Lu-Chengyu/TR19/TR19_DR/TR19_DR.pdf

共 39 页 第 1 页

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
# 传动系统设计报告

## 编著：陆成禹 胡啸 梁家豪

共 39 页 第 2 页

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
共 39 页 | 第 3 页 ┊┊┊┊┊┊┊┊┊┊┊┊┊装┊┊┊┊┊订┊┊┊┊┊线┊┊┊┊┊┊┊┊┊┊┊┊┊ | 1 设计目标 加速性能，传递效率，可靠性，轻量化。

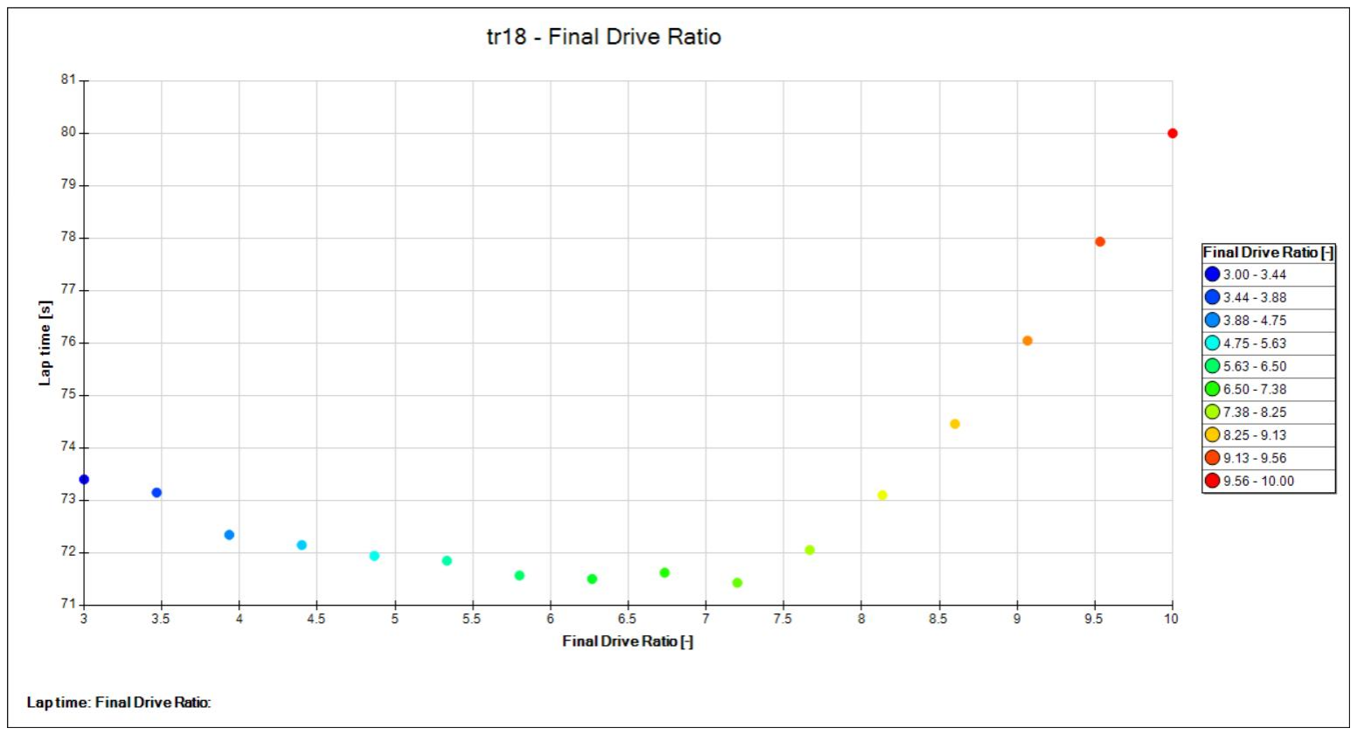
[picture p1: figure]
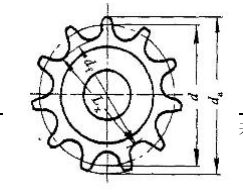
[picture p2: figure]

共 39 页 第 4 页

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
## 2 设计步骤

主减速比的选择
各部件的受力计算
借助 CAE 分析优化结构

2.1.主减速比的选择

我们用 Optimum lap 对中国赛赛道进行了仿真。图表中 X 轴是减速比，Y 轴是最快圈速。根 据仿真结果，我们可以看出减速比在 6~8 之间，减速比对最快圈速的影响最小。次减速比为 1.974， 所以主减速比的范围为 3~4。
根据以往赛季的数据，赛车直线加速的最终速度为 v = 109km / h = 30.28m / s。 当轮胎压力

## 为 0.8bar 时，车轮的滚动半径为 235.1mm。 根据 v =2πnr（n ----加速时的最终车轮转速），有 n= v /2πr=21.81r/ S =1308.4r/min。

为了节省换档时间，我们的换档策略是在加速完成时达到换档点。 因此，我们使发动机的 速度达到 12810r / min，达到齿轮 3 到齿轮 4 的换档点。

小链轮的齿不应太小，因为这会导致小的交叉角，每个齿承受太大的负荷。 但是，由于空 间的限制，轮齿也不能太大。 所以我们选择链轮的齿数为素数 11。

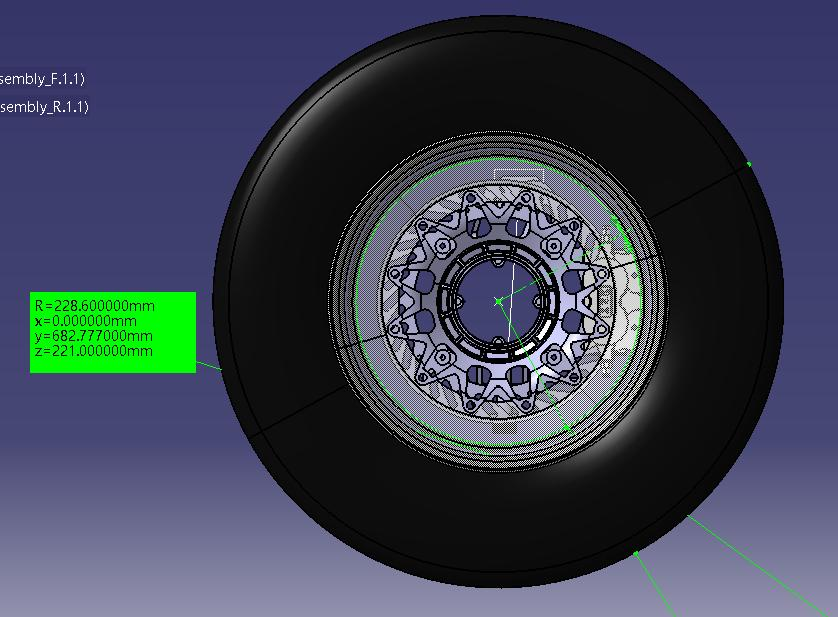
[picture p3: figure]

共 39 页 第 5 页

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
图 2.4 小链轮

另外，TR-19 轮胎重 6.7 千克，具有一定的转动惯量。

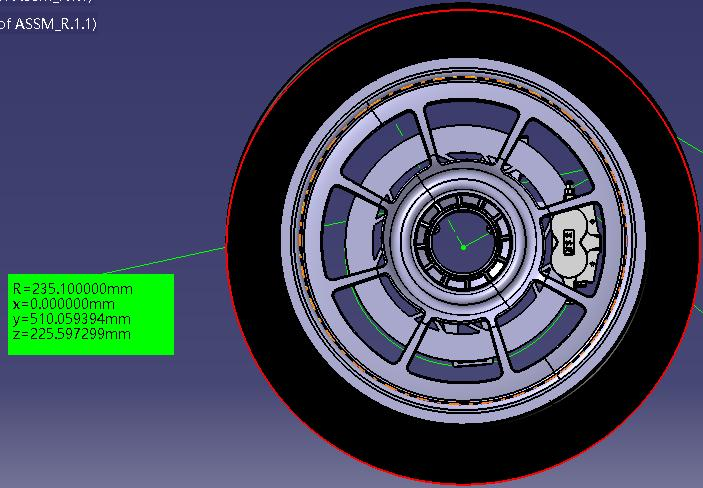
[picture p4: figure]

图 2.5 TR-18 | 图 2.6 TR-17

结合上一辆车 TR18 的主减速比 38：11，最终我们选择保持传动比不变，将 TR19 的主减速

## 比定为 38:11。

2.2.各部件的受力计算

发动机最大输出扭矩 M：54N.m

小链轮上的扭矩 M1

大连轮上的扭矩 M2

发动机提供给半轴的扭矩 M3

赛车加车手总重 M4：270kg

赛车重心高度 h：321mm

共 39 页 第 6 页

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
## 赛车前后轴距 L：1578.5mm

静载荷前后分配：45：55

## 车轮滚动半径 r0：235.1mm

2.2.1 支撑受力

支撑受力分析

= + + + ∆1 + ∆2 (2.1)

其中：
：紧边拉力

：有效圆周力

：离心力引起的拉力

：悬垂拉力
= + (2.2)

其中：
：松边拉力
v =
1p

60×1000 =
11×15.875×2182.77

60×1000 = 6.35 (2.3)

其中：
1:小链轮齿数

：链条节距

：小链轮转速

大、小链轮分度圆半径
1 = 28.2
2 = 28.2 ×

38
11 = 97.4

链条变速运动最大加速度
=

# 21 sin

180° 1 =
6.35

# 2 28.2×10−3 sin

180° 11 = 402.84/
2 | (2.4)

共 39 页 第 7 页

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
从动链轮角加速度
2 d =

# 2cos (180° 2) =

402.84

# 97.4×10−3×cos (180° 38) = 4150.11rad/

2
(2.5)

其中：
2：大链轮转速

2：大链轮齿数

发动机输出有效圆周力
= 1000

= 1000 ×
55

6.35 = 8661.42 （2.6）

其中：
:发动机输出功率

链条离心力引起拉力
=

2 = 1.02 × 6.35

2 = 41.13 (2.7)

其中：
：链条单位长度质量

链条垂悬拉力
= + s = 25 + s0° × 1.02 × 0.1902 × 100 = 486.44 (2.8)

其中：
：大小链轮中心线与水平面夹角

：链传动中心距

：重力加速度

：垂度系数

的值参考下图选取

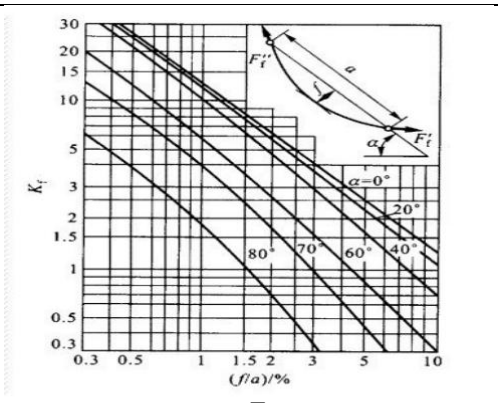
[picture p5: figure]

共 39 页 第 8 页

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
图 2.7

链速变化引起惯性力
∆1 = = 1.02 × 0.82 × 402.84 = 328.72 (2.9)

其中：
：紧边链条的长度

角加速度引起的惯性力

∆2 =

2 ×

2 d =
0.002×4150.11

97.4×10−3 = 85.22 (2.10)

其中：
：从动系统转化到从动链轮轴上的转动惯量

所以
= + + + ∆1 + ∆2 = 9602.93 | (2.1)
= + =527.57N | (2.2)

共 39 页 | 第 9 页 ┊┊┊┊┊┊┊┊┊┊┊┊┊装┊┊┊┊┊订┊┊┊┊┊线┊┊┊┊┊┊┊┊┊┊┊┊┊ | 图 2.8 链传动布置简图 = cos 20.934° + cos 20.934° = 9461.82 | (2.12) = sin 20.934° − sin 20.934° = 3240.88 | (2.13) X 方向 | 图 2.9 Y 方向

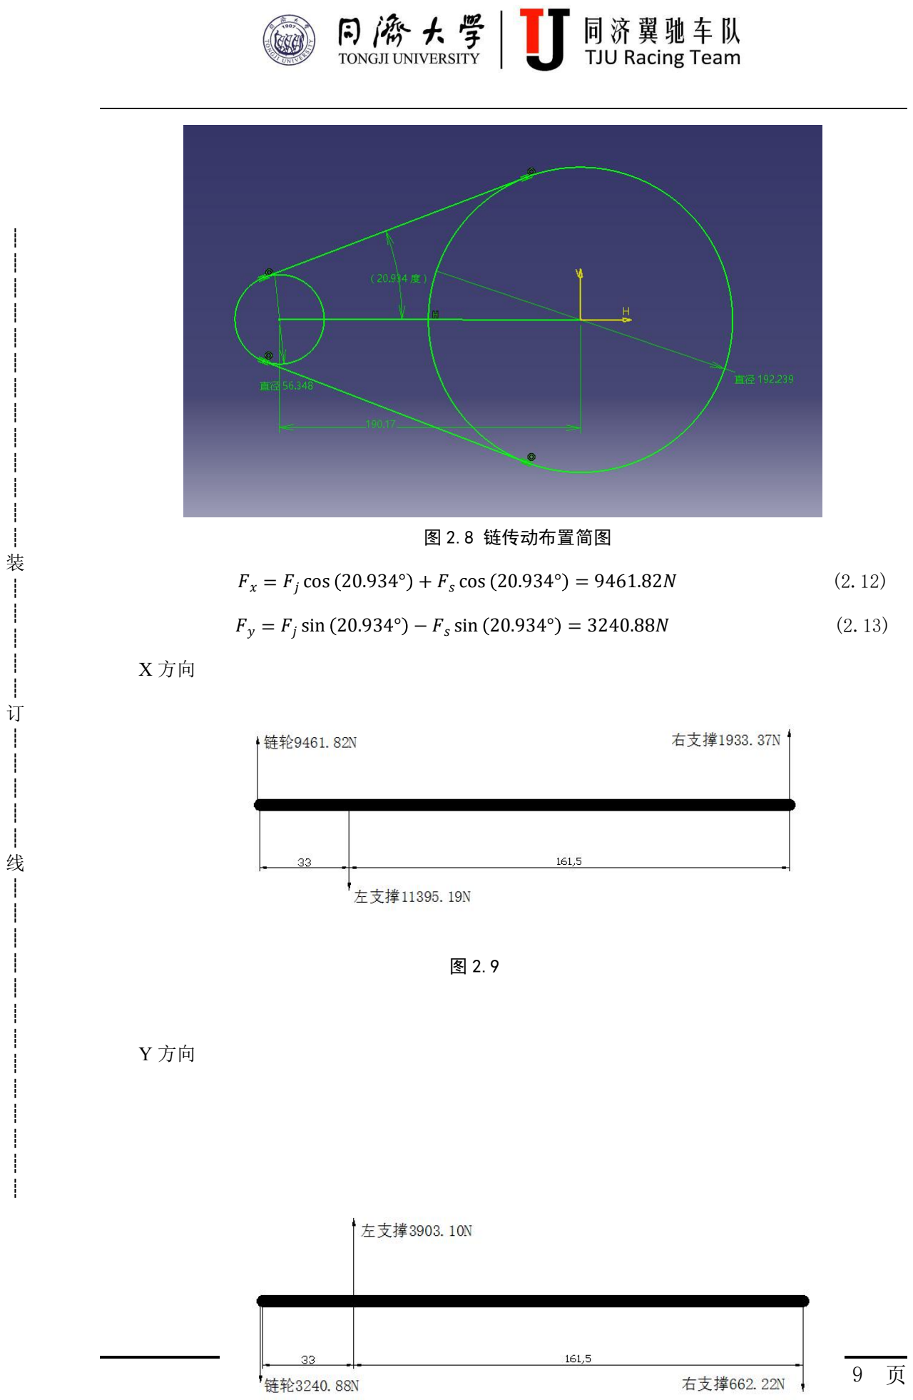
[picture p6: page 9]

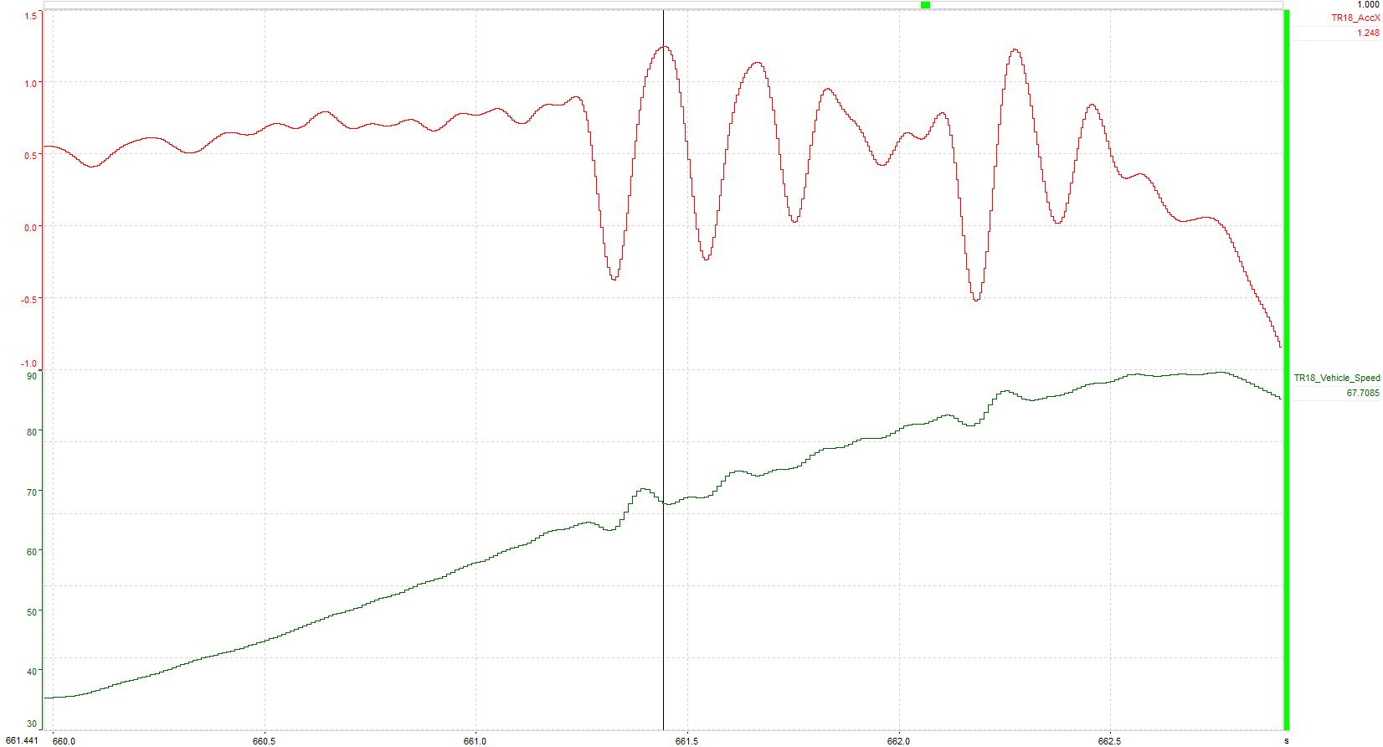
[picture p7: figure]

共 39 页 第 10 页

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
图 2.10

2.2.2 扭矩计算

发动机提供的扭矩：
1 = × 0 × 2.785 = 269.38 ∙ (2.14) 2 = 1 × = 269.38 ×
38
11 = 930.59 ∙ | (2.15)
3 = 2 ÷ 2 = 930.59 ÷ 2 = 465.29 ∙ | (2.16)

根据测试的数据收集计算轮胎提供的扭矩。 （详细数据见附件）

图 2.11 后轮最大垂直力下的速度和加速度

根据图 2.8，最大加速度 a = 1.248g，v = 67.7km / h。

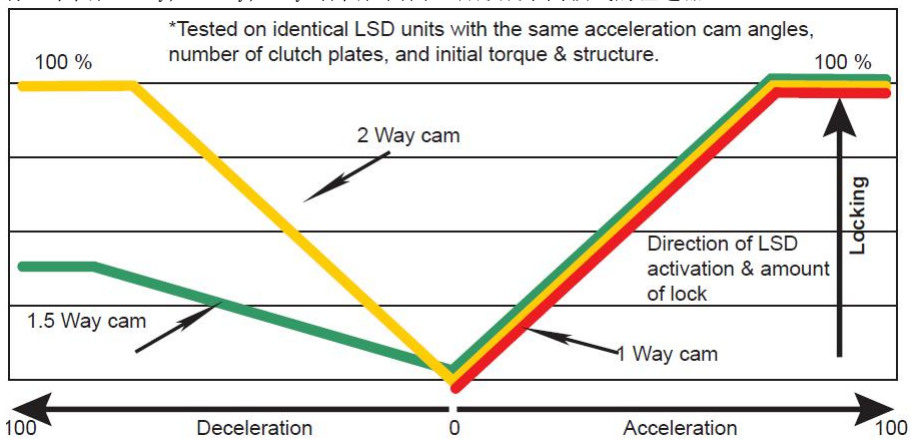
[picture p8: figure]

共 39 页 第 11 页

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
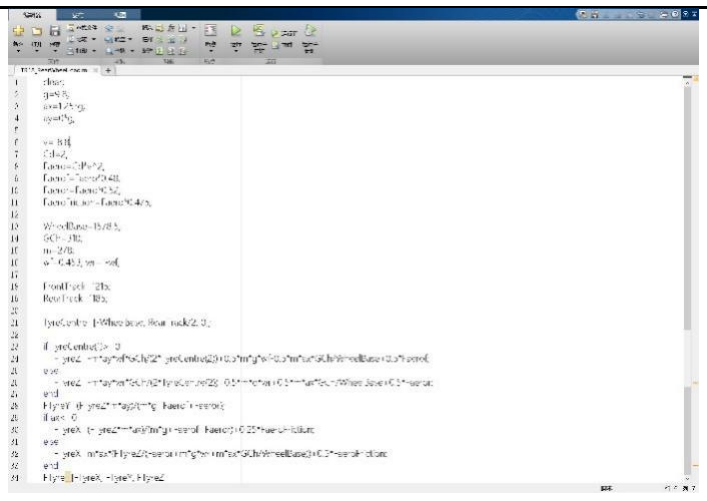
[picture p9: figure]

图 2.12 Matlab 计算

从 MATLAB 我们可以看出 y 轴上的最大应力是 1870.6N。 轮胎半径为 235mm。 我们可以得到 最大扭矩为 439.6Nm。 又 439.6Nm <465.29Nm，我们选择 465.29Nm 作为模拟时的最大扭矩。

2.3 结构设计及其仿真优化

2.3.1CUSCO 差速器与差速器壳分析

Cusco 最大的优势是锁紧系数和限滑系数可调，同时 cusco 每款差速器具有两档可调（一共 有三个档位 1way,1.5way,2way.各档位两两组合形成不同款式的差速器）。

图 2.13 Cusco 差速器各档位与锁紧系数关系[3]

图 2.13 是 Cusco 不同档位的特性图。各档位加速时性能都一样。在减速时：1way 没有摩擦 扭矩，锁紧系数始终为 0；1.5way 锁紧系数逐渐上升到 0.375 左右；2.0way 锁紧系数能达到 1。

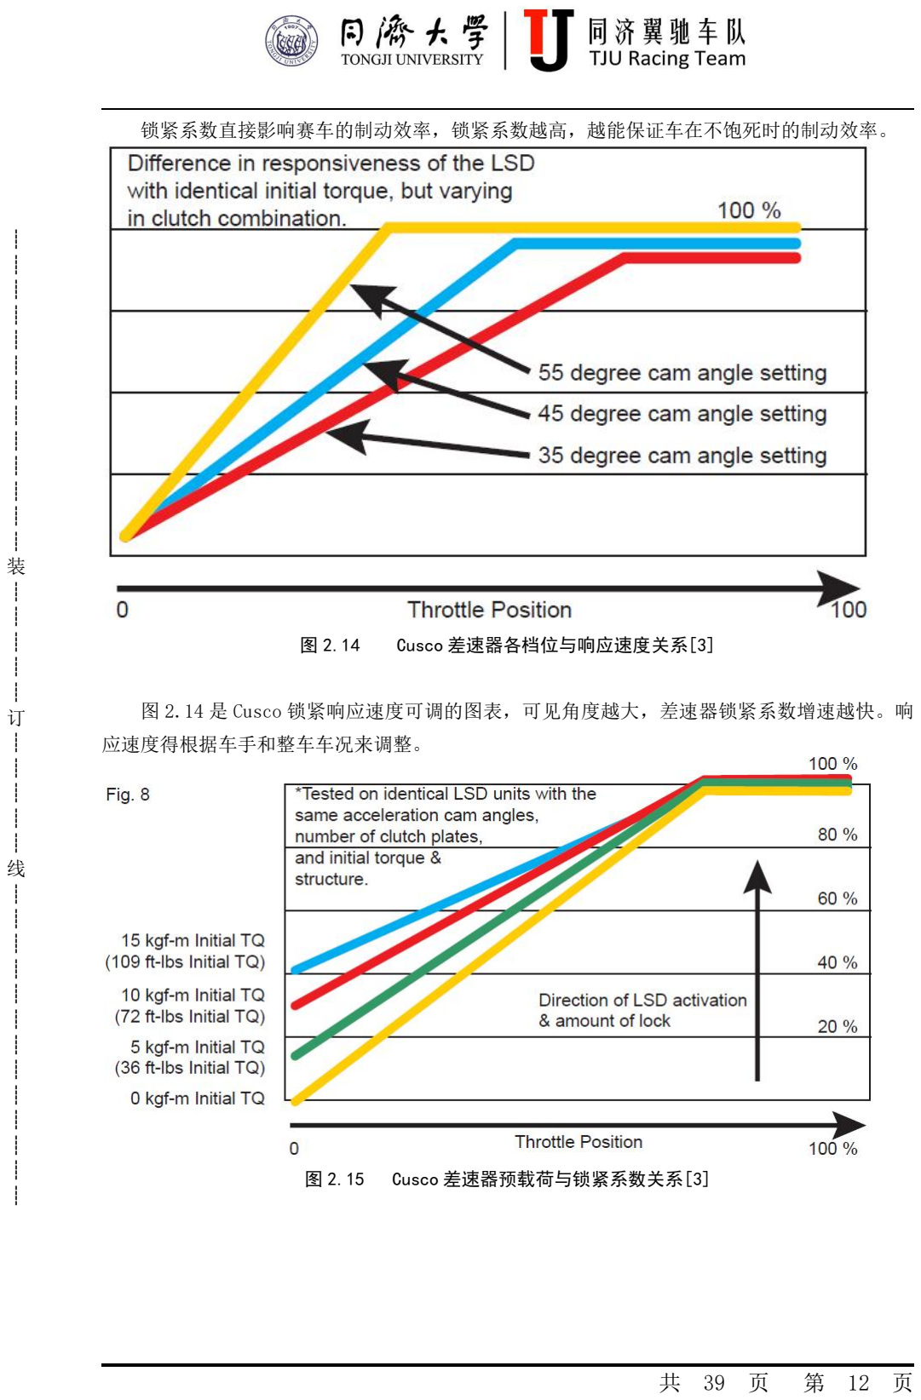
[picture p10: page 12]

共 39 页 第 12 页

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
锁紧系数直接影响赛车的制动效率，锁紧系数越高，越能保证车在不饱死时的制动效率。

图 2.14 Cusco 差速器各档位与响应速度关系[3]

图 2.14 是 Cusco 锁紧响应速度可调的图表，可见角度越大，差速器锁紧系数增速越快。响 应速度得根据车手和整车车况来调整。

图 2.15 Cusco 差速器预载荷与锁紧系数关系[3]

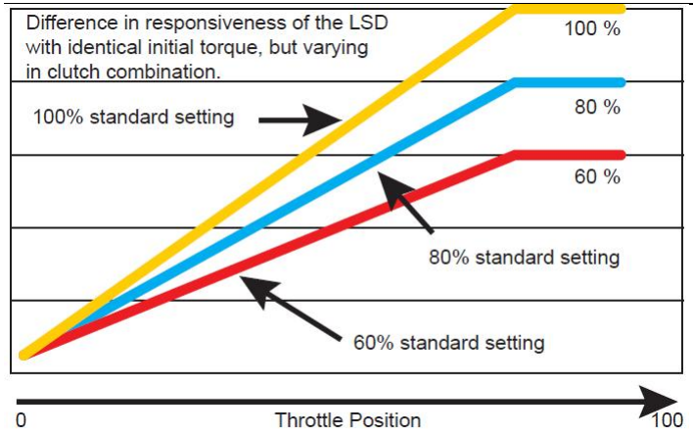
[picture p11: figure]

共 39 页 第 13 页

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
图 2.16 Cusco 差速器摩擦片排序与锁紧系数关系[3]

图 2.15 与图 2.16 是 Cusco 锁紧系数可调的图表，图 2.15 是通过调整预紧力来调整起始锁 紧系数，图 2.16 是通过调整摩擦片顺序来调整最大锁紧系数。这些得通过赛道和车况以及车手 感受来调整。下面是一个实车调整的情况。

由于以上特性，所以我们选择了 CUSCO 差速器。

原装的 cusco 差速器壳的材料是钢，重量比较大，为了满足轻量化的要求，我们决定自制差 速器壳。材料方面我们选用 7075 铝，这样能够保证了外壳的强度。并且在表面进行了阳极氧化

处理，增加了表面的硬度。在保证了可靠性的同时确保其密封性，在左右外壳的端口都采用双油 封密封，左右外壳连接处采用 O 型圈密封。

鉴于链轮以及差速器壳将承受 930.6N.m 的扭矩，考虑见小链轮的实际冲击载荷以及链轮的

轻量化，将采用渐开线花键形式连接链轮和差速器壳。

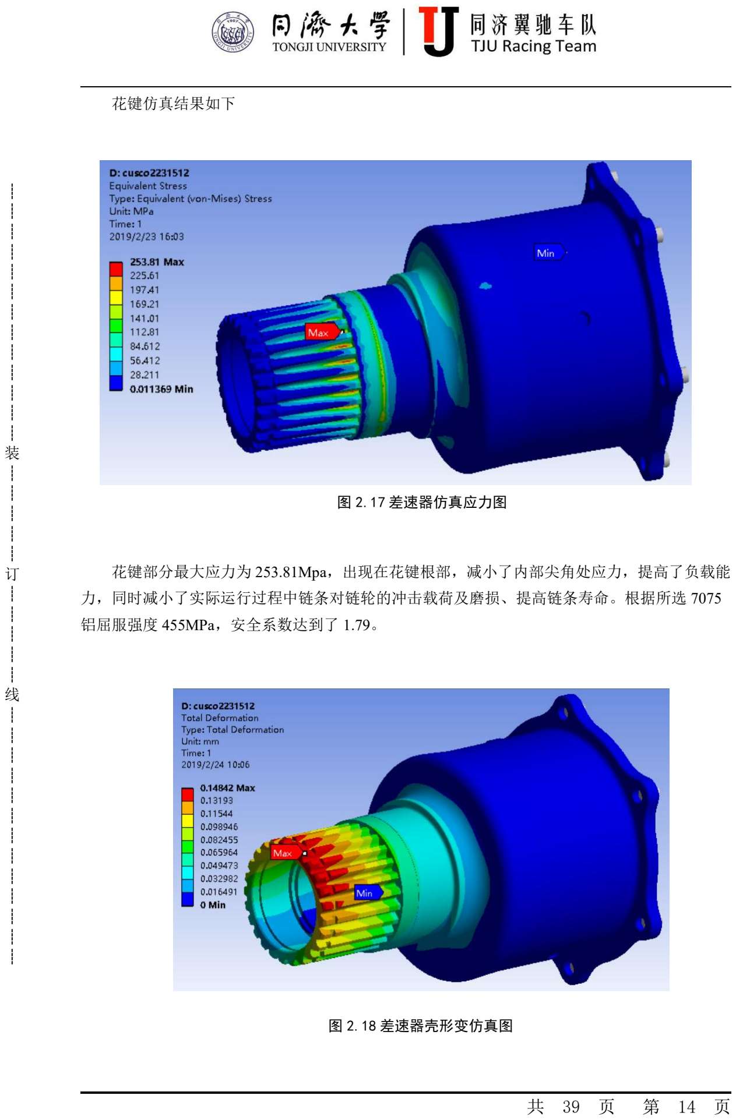
[picture p12: page 14]

共 39 页 第 14 页

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
花键仿真结果如下

图 2.17 差速器仿真应力图

花键部分最大应力为 253.81Mpa，出现在花键根部，减小了内部尖角处应力，提高了负载能 力，同时减小了实际运行过程中链条对链轮的冲击载荷及磨损、提高链条寿命。根据所选 7075 铝屈服强度 455MPa，安全系数达到了 1.79。

图 2.18 差速器壳形变仿真图

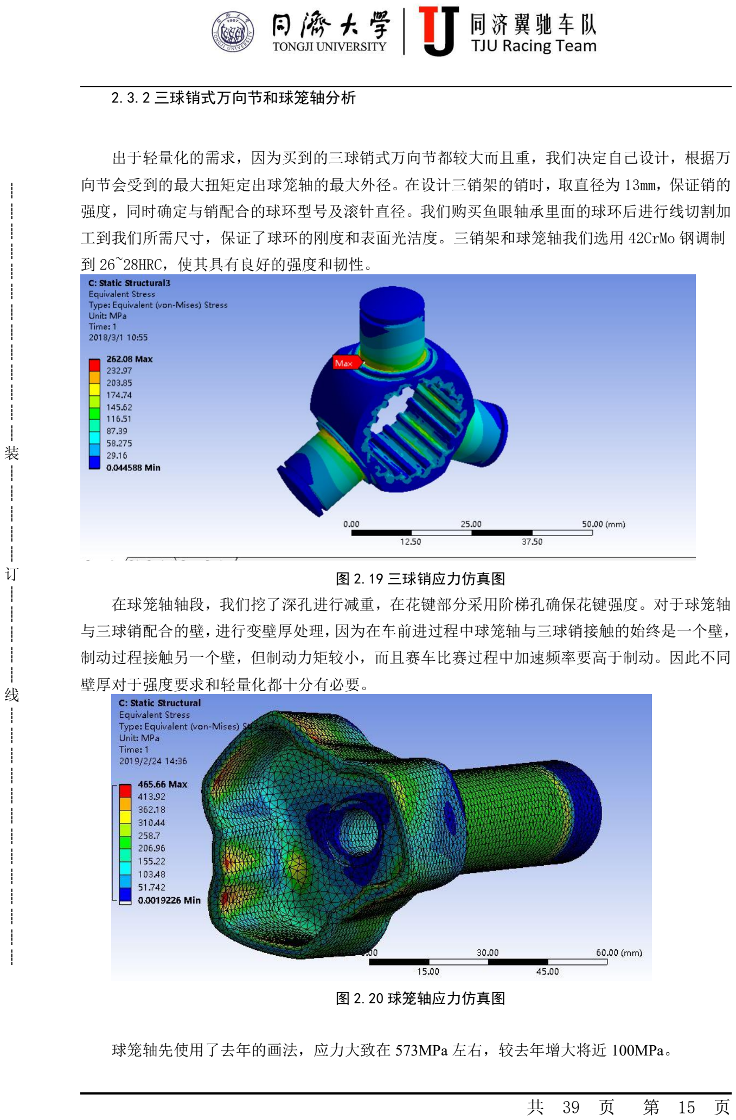
[picture p13: page 15]

共 39 页 第 15 页

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
2.3.2 三球销式万向节和球笼轴分析

出于轻量化的需求，因为买到的三球销式万向节都较大而且重，我们决定自己设计，根据万 向节会受到的最大扭矩定出球笼轴的最大外径。在设计三销架的销时，取直径为 13mm，保证销的 强度，同时确定与销配合的球环型号及滚针直径。我们购买鱼眼轴承里面的球环后进行线切割加 工到我们所需尺寸，保证了球环的刚度和表面光洁度。三销架和球笼轴我们选用 42CrMo 钢调制 到 26~28HRC，使其具有良好的强度和韧性。

图 2.19 三球销应力仿真图
在球笼轴轴段，我们挖了深孔进行减重，在花键部分采用阶梯孔确保花键强度。对于球笼轴 与三球销配合的壁，进行变壁厚处理，因为在车前进过程中球笼轴与三球销接触的始终是一个壁， 制动过程接触另一个壁，但制动力矩较小，而且赛车比赛过程中加速频率要高于制动。因此不同 壁厚对于强度要求和轻量化都十分有必要。

图 2.20 球笼轴应力仿真图

球笼轴先使用了去年的画法，应力大致在 573MPa 左右，较去年增大将近 100MPa。

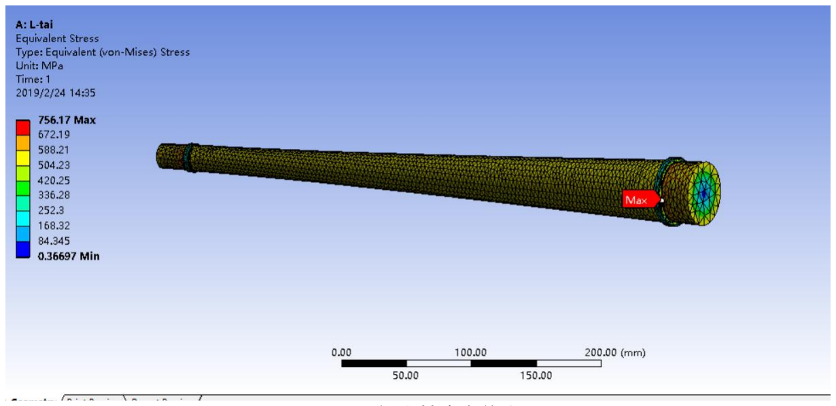
[picture p14: figure]

共 39 页 第 16 页

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
于是今年的球笼轴在厚壁的画法上做了一些改动，从仿真结果可以看出，最大应力集中在囚

笼位置为 465MPa 左右，较去年减少 26MPa。质量较去年减少 20g。

2.3.3 半轴分析

处于轻量化考虑，我们在 TR17 上装备了钛半轴，效果较好，今年我们决定在 TR18 上继续使 用钛半轴。半轴是传动系统的重要受力部件之一，为了确保钛半轴的可靠性，我们在学院实验室 做了钛半轴和钢半轴的扭转试验对比。（详见附录）
由于钛合金材料的加工特性，我们设计了不同于钢半轴的花键。将加工工艺由原来的电火花 成型改为了滚齿成型。同时也体现出了自制三销轴万向节的便利性，可以根据半轴想要的花键而 变更设计。
从仿真结果来看，最大应力点在轴肩底部，大小为 756.17MPa，符合我们的设计需求。 同时考虑成本，对空心钢半轴也进行了仿真，对比钛半轴空心钢增重 220 克左右，但受力情 况较好。

图 2.2.1 钛半轴应力仿真图

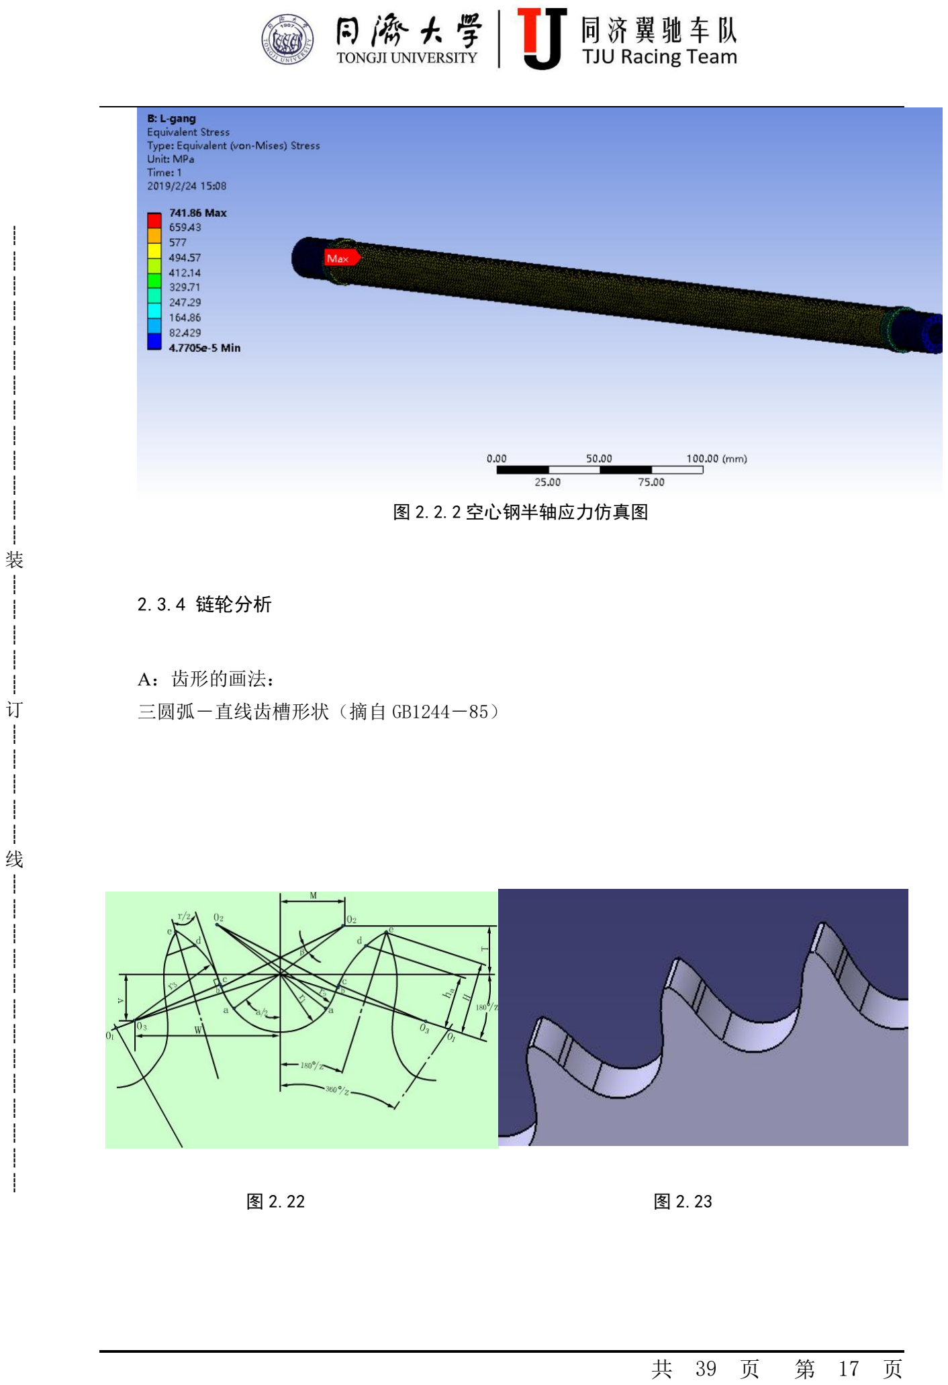
[picture p15: page 17]

共 39 页 | 第 17 页 ┊┊┊┊┊┊┊┊┊┊┊┊┊装┊┊┊┊┊订┊┊┊┊┊线┊┊┊┊┊┊┊┊┊┊┊┊┊ | 图 2.2.2 空心钢半轴应力仿真图 2.3.4 链轮分析 A：齿形的画法： 三圆弧－直线齿槽形状（摘自 GB1244－85） 图 2.22 | 图 2.23

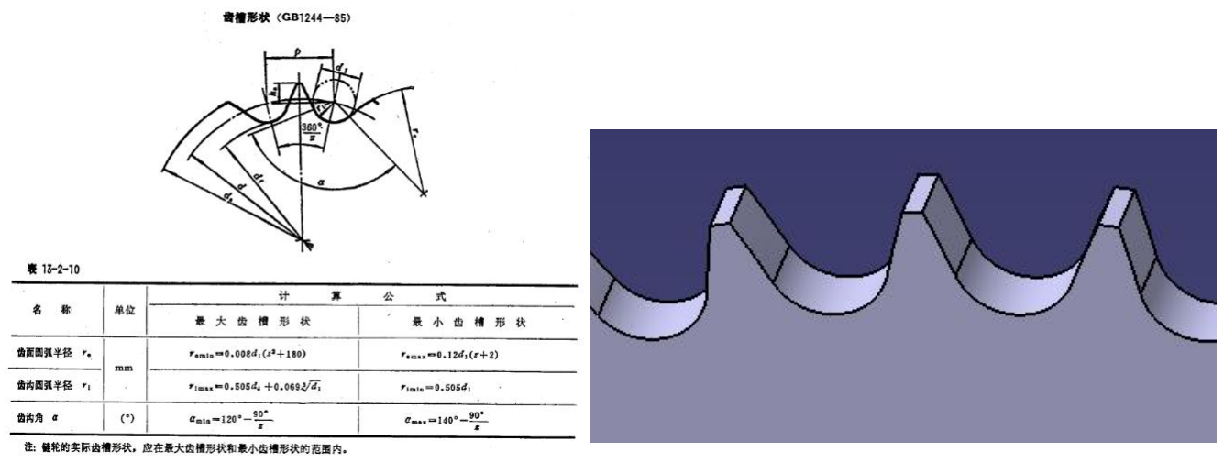
[picture p16: figure]

共 39 页 第 18 页

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
二圆弧法

图 2.24 | 图 2.25
比较以上两种画法发现，三圆弧法优势有：目前比较标准的画法，用标准刀具加工，取值比 较确定；不容易跳齿；磨损较小。且镂空结构相同时，三圆弧法得到的链轮强度更好，最终选取 三圆弧法确定齿形。

B 镂空部分的设计

设计几种不同的镂空部分形状，结合 Ansys 仿真分析后，发现几种设计中，去年的设计受力 更为合理。
由于采用全新的镂空方式，最大应力达到 283Mpa。

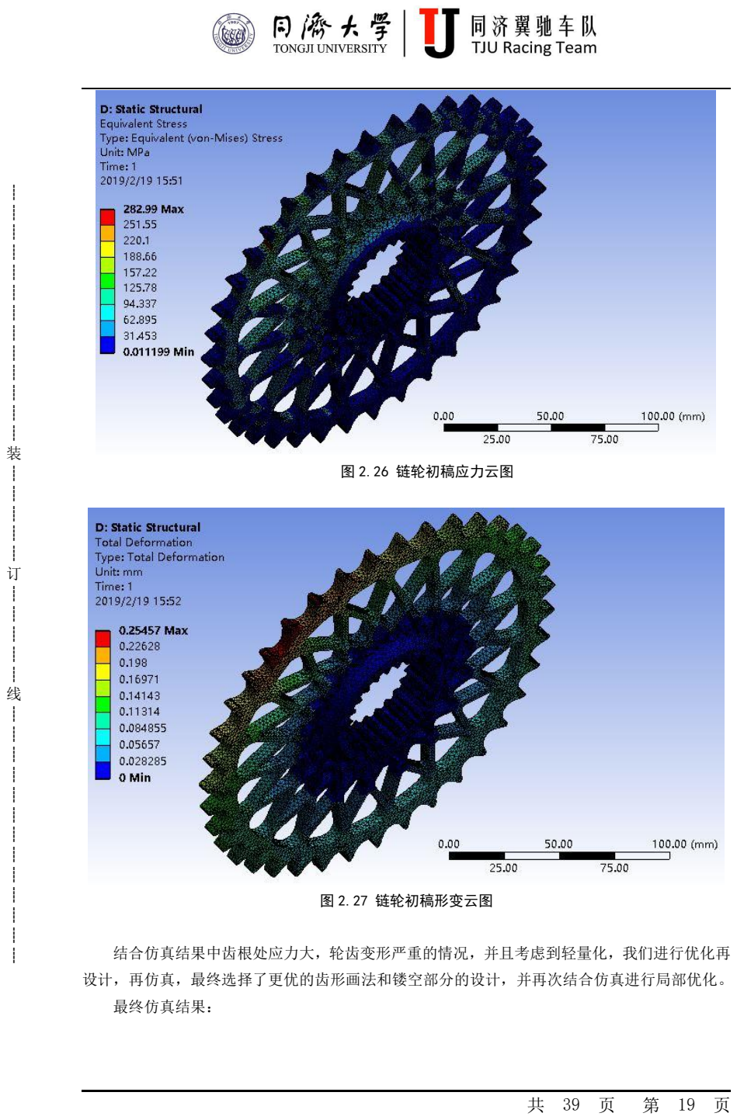
[picture p17: page 19]

共 39 页 第 19 页

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
图 2.26 链轮初稿应力云图

图 2.27 链轮初稿形变云图

结合仿真结果中齿根处应力大，轮齿变形严重的情况，并且考虑到轻量化，我们进行优化再 设计，再仿真，最终选择了更优的齿形画法和镂空部分的设计，并再次结合仿真进行局部优化。 最终仿真结果：

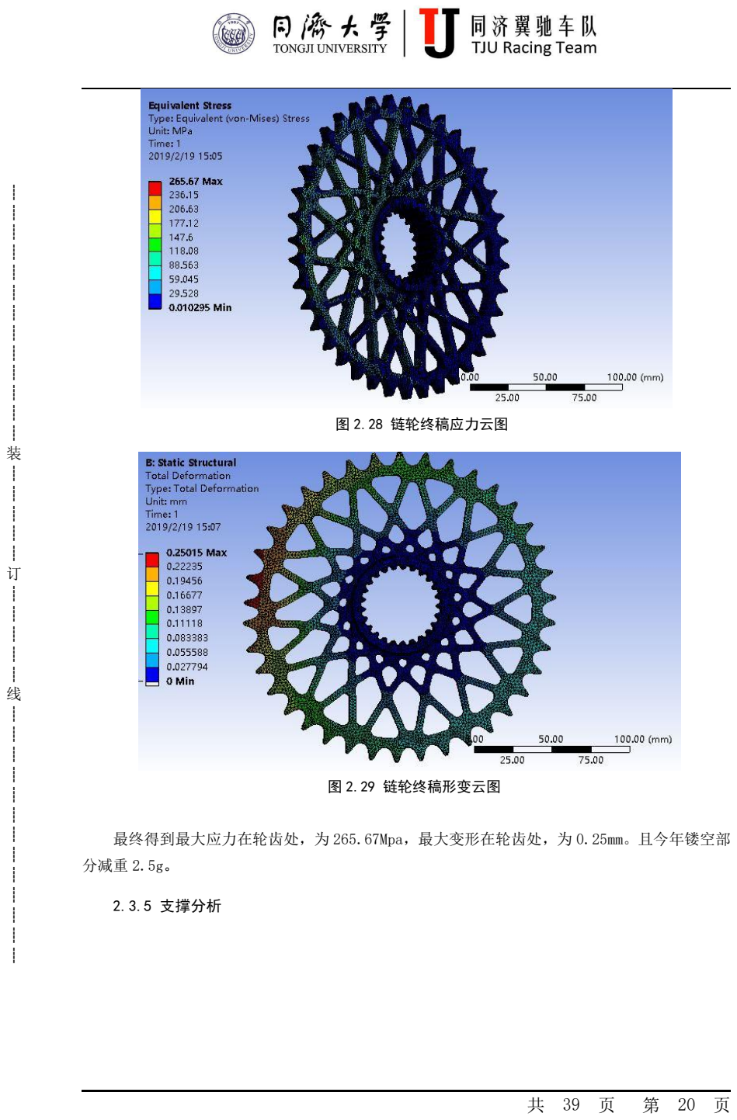
[picture p18: page 20]

共 39 页 第 20 页

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
图 2.28 链轮终稿应力云图

图 2.29 链轮终稿形变云图

最终得到最大应力在轮齿处，为 265.67Mpa，最大变形在轮齿处，为 0.25mm。且今年镂空部 分减重 2.5g。

2.3.5 支撑分析

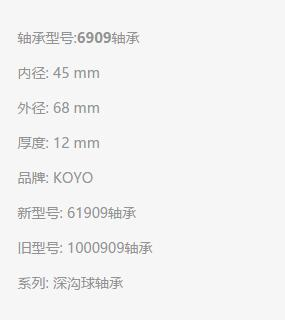
[picture p19: figure]
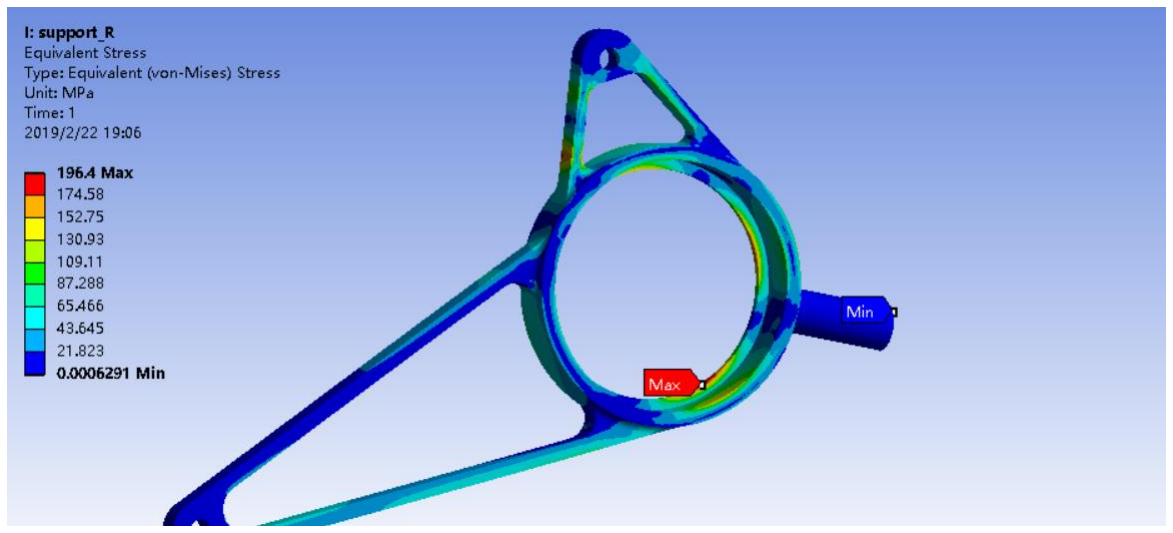
[picture p20: figure]

共 39 页 第 21 页

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
在选定差速器轴承型号后（见附录二），根据轴承型号给定的数据，以及差速器轴线与发动 机上下悬的相对位置，进行支撑设计。

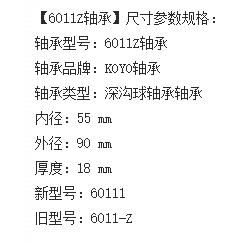
[picture p21: figure]

图 2.30 | 图 2.31

右支撑受力较小，差速器轴线与发动机下悬轴线距离与去年相比变化很小，右支撑质量与去 年相比减少 3.95g，且有较好的应力与形变。

图 2.32 右支撑应力云图

左支撑进行了三种改进尝试，前两种方案虽降低了镂空处最大应力，但由于螺栓连接处最大 应力较大，在结合质量与应力的考虑下，选择方案 A，应力较去年相比稍大，质量减轻 4.76g， 安全系数达 2.02

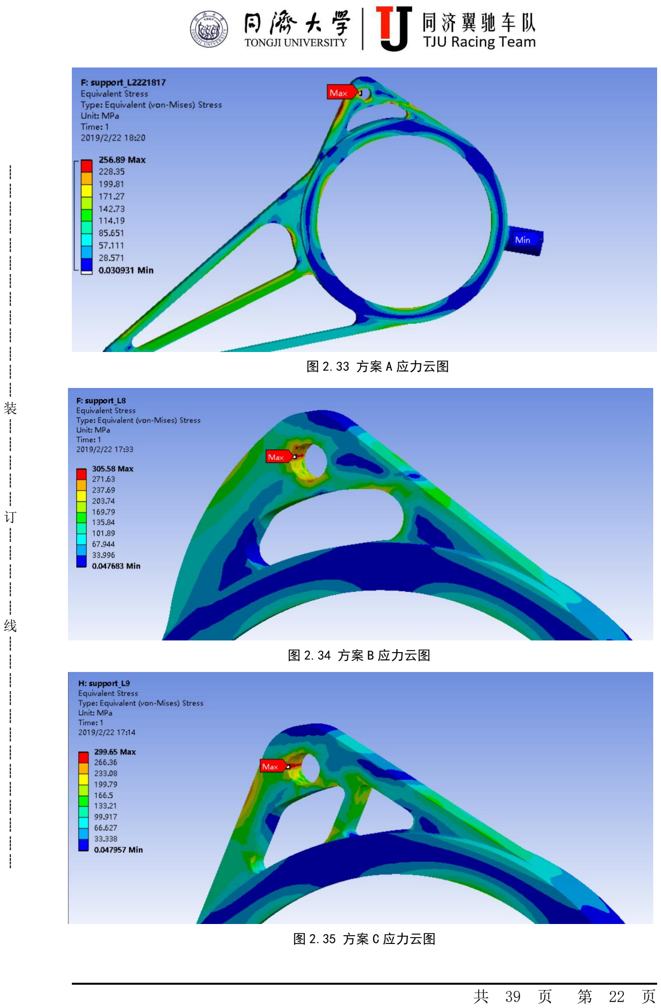
[picture p22: page 22]

共 39 页 | 第 22 页 ┊┊┊┊┊┊┊┊┊┊┊┊┊装┊┊┊┊┊订┊┊┊┊┊线┊┊┊┊┊┊┊┊┊┊┊┊┊ | 图 2.33 方案 A 应力云图 图 2.34 方案 B 应力云图 图 2.35 方案 C 应力云图

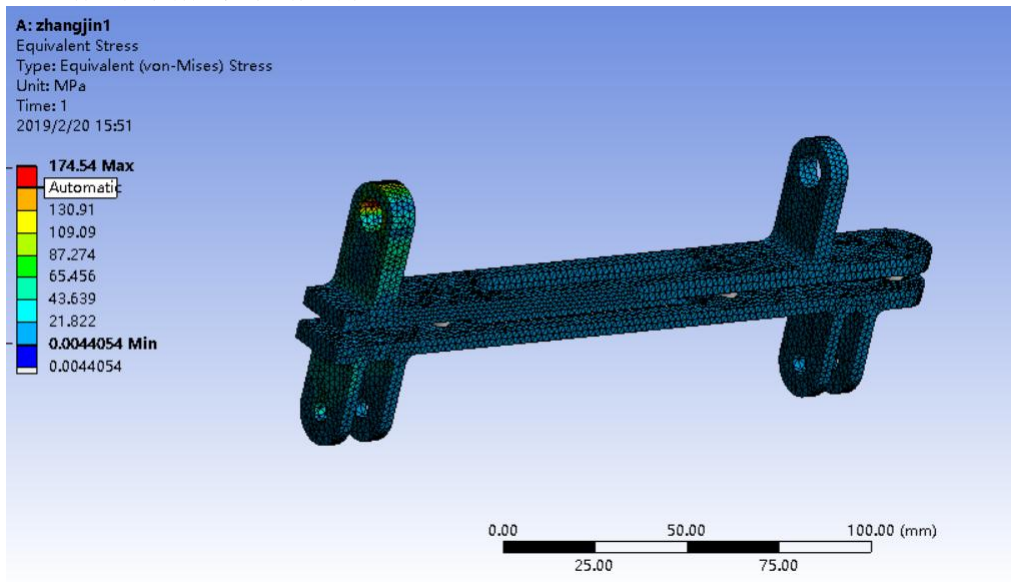
[picture p23: figure]

共 39 页 第 23 页

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
2.3.6 张紧分析

为了减轻张力，我们决定选择 7075 铝合金作为张紧材料。根据差速器壳的数模和轴线间的 相对位置，进行张紧设计，由于去年设计时没有考虑上张上平面到发动机上悬制的距离，车检时 扳手与发动机上悬制发生干涉，增加了车检的工作量，今年设计将上张紧螺栓孔与上平面的距离 增加 7mm，保证扳手有足够的工作空间。

图 2.35 张紧应力云图

2.3.7 吊耳分析

今年所采用的吊耳方案与 TR17 相似，材料选取 42CrMo 钢。设计吊耳的过程中不断调整 三个点的相对位置，再进行仿真，寻找应力相对较小的方案。

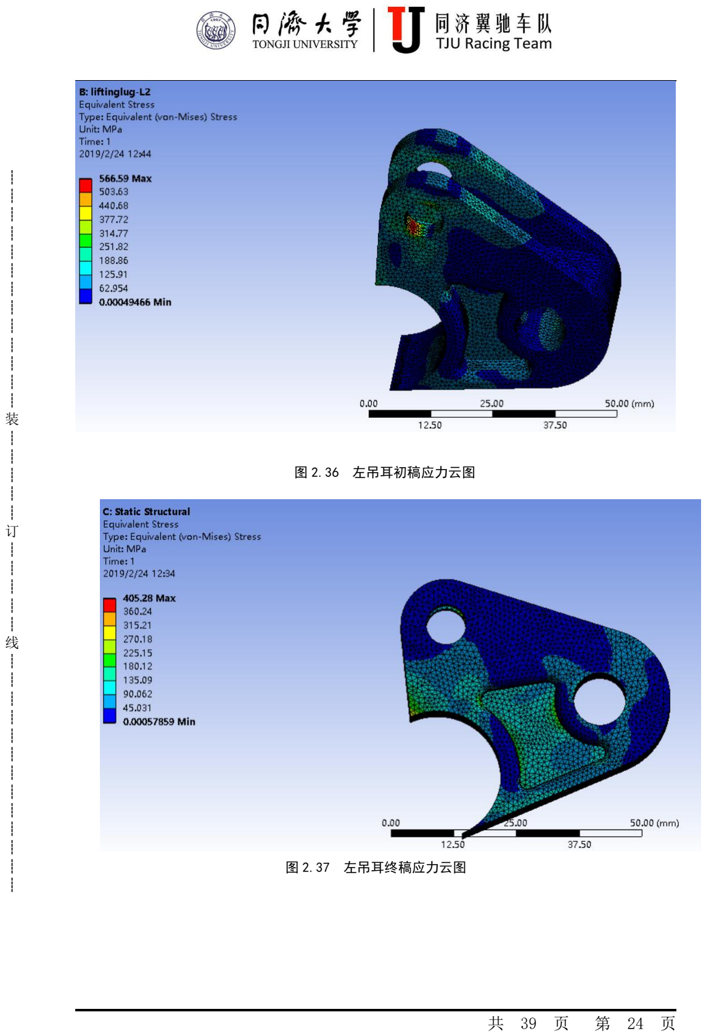
[picture p24: page 24]

共 39 页 | 第 24 页 ┊┊┊┊┊┊┊┊┊┊┊┊┊装┊┊┊┊┊订┊┊┊┊┊线┊┊┊┊┊┊┊┊┊┊┊┊┊ | 图 2.36 左吊耳初稿应力云图 图 2.37 左吊耳终稿应力云图

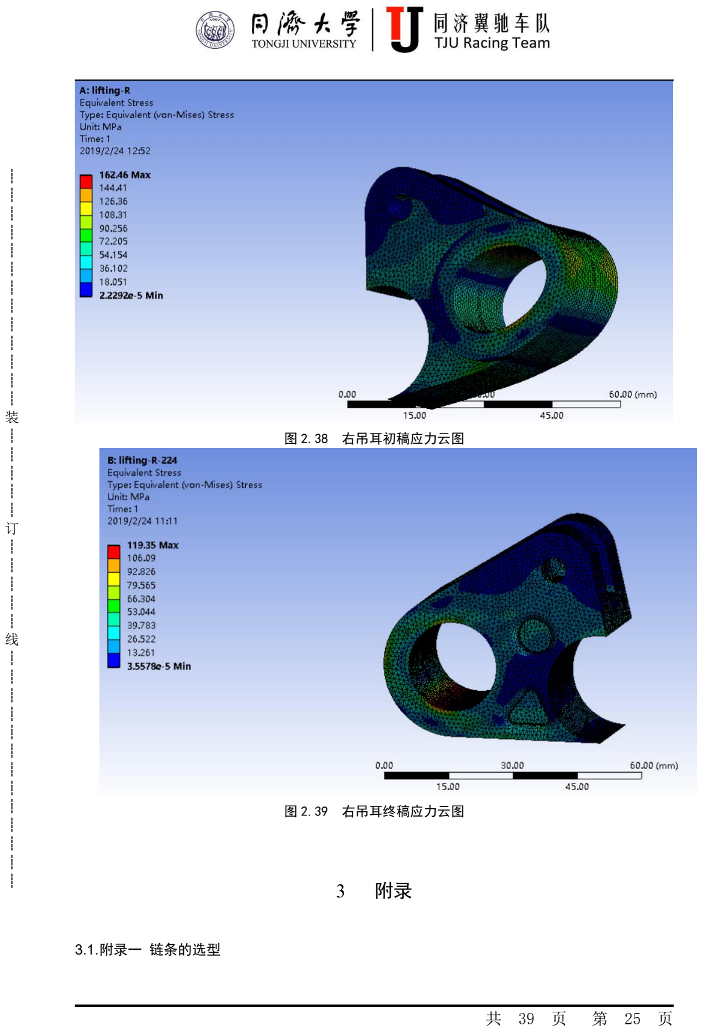
[picture p25: page 25]

共 39 页 | 第 25 页 ┊┊┊┊┊┊┊┊┊┊┊┊┊装┊┊┊┊┊订┊┊┊┊┊线┊┊┊┊┊┊┊┊┊┊┊┊┊ | 图 2.38 右吊耳初稿应力云图 图 2.39 右吊耳终稿应力云图 3 附录 3.1.附录一 链条的选型

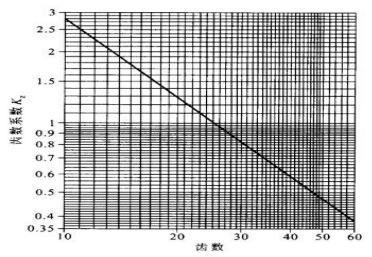
[picture p26: figure]

共 39 页 第 26 页

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
A. 选择链轮的齿数、传动比 i：
B.计算当量的单排链的计算功率 Pca. 一定条件下，节距越大，链传动的承载能力越强，但节距越大，链传动的多边形效应越严重，

动载荷、冲击、振动越严重。所以，考虑到赛车的轻量化，为使链传动结构紧凑、寿命长，尽量 取小节距的单排链。
根据链传动的工作情况、主动链轮齿数和链条排数，将链传动所传递的功率修正为当量的单 排链的计算功率

———工况系数，见表 3.1 ———主动链轮齿数系数，见表 3.2 ———单排链系数，双排链时，三排链时

P=49.6KW(取自发动机试验测量数据）——传递的功率，KW（千瓦）。

表 3.1 工况系数
从动机械特性 | 主动轮机械特性
平稳运动 | 轻微冲击 | 中等冲击
平稳运动 | 1.0 | 1.1 | 1.3
轻微冲击 | 1.4 | 1.5 | 1.7
中等冲击 | 1.8 | 1.9 | 2.1

图 3.1 主动链轮齿数系数

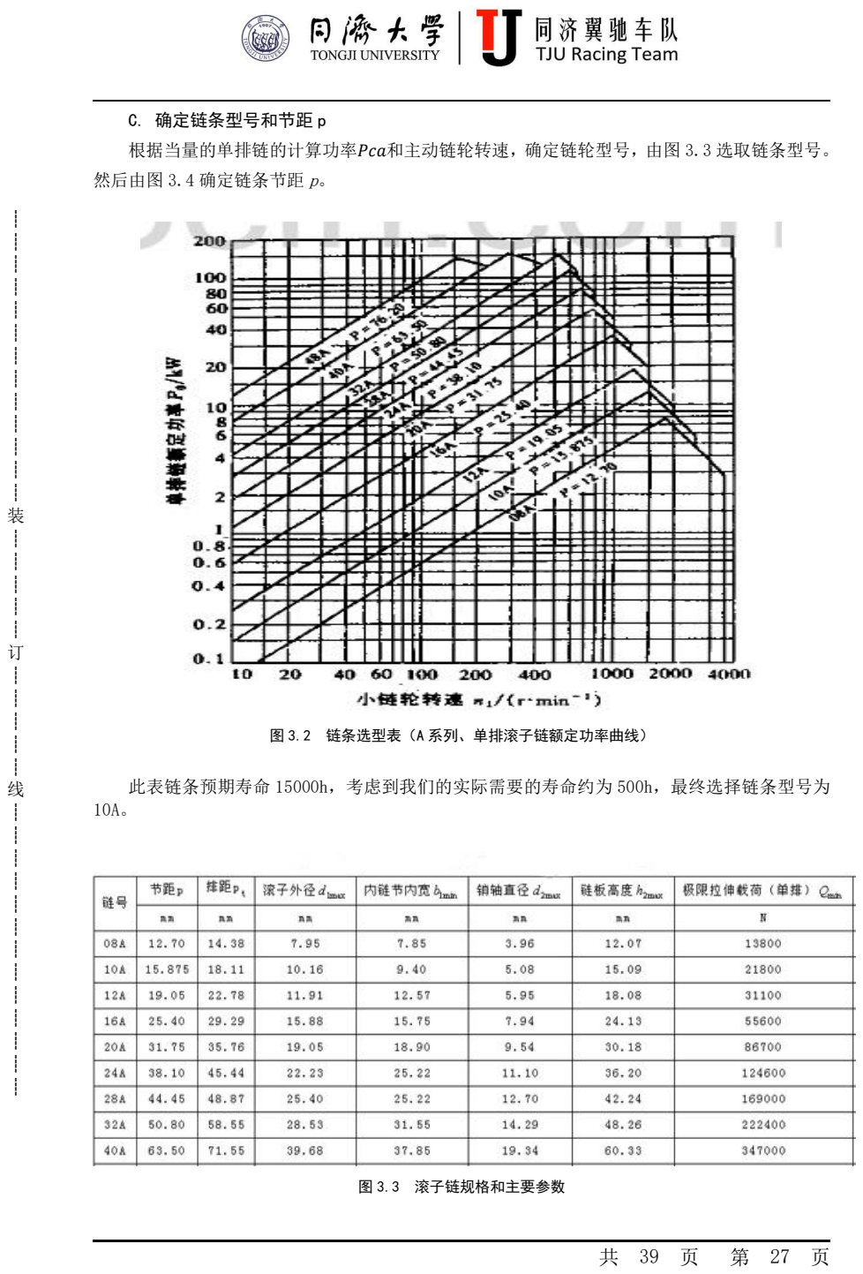
[picture p27: page 27]

共 39 页 第 27 页

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
C. 确定链条型号和节距 p

根据当量的单排链的计算功率和主动链轮转速，确定链轮型号，由图 3.3 选取链条型号。

然后由图 3.4 确定链条节距 p。

图 3.2 链条选型表（A 系列、单排滚子链额定功率曲线）

此表链条预期寿命 15000h，考虑到我们的实际需要的寿命约为 500h，最终选择链条型号为 10A。

图 3.3 滚子链规格和主要参数

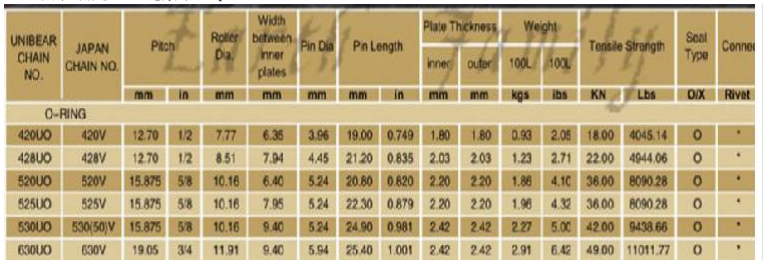
[picture p28: figure]

共 39 页 第 28 页

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
由表确定 10A 链条节距 p=15.875mm

图 3.4
符合节距要求的链条有 520,525,530 三种，考虑到轻量化要求，初选型 520，节距 15.875mm
3.2. 附录二 差速器支撑轴承的选型

3.2.1 左轴承选型

左支撑主要受径向力，受轴向力较小，故选用深沟球轴承。根据轴承使用需求取 200h 为 额定寿命。

# Lℎ = 200h

基本额定载荷 C

# C = Pε

60ℎ 106 | (3.1)

对于深沟球轴承，指数为ε = 3

（1）求轴承的当量动载

P = ( + ) | (3.2)
查表 3.1 取 | 1.3 d
f =

表 3.2

载荷性质 | fd

共 39 页 第 29 页

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
由于轴承不受轴向力，所以径向动载荷系数 X=1，轴向动载荷系数 Y=0
= 0 < | (3.3)
X = 1, Y = 0, P = × | (3.4)
P = 1.3 × 11496.37

2 + 3935.86

2 = 15796.87

（2）求转速
=
s ( = 1,2; = , ) (3.5)

发动机最大输出扭矩下轴承转速

n = 12000/s
i = 1.974 × 2.785 × 38/11 = 19.61 1 = 611.93/s

（3）求基本额定载荷 C

# C = Pε

60ℎ 10
6 | (3.1)
= 31.1

根据《机械设计手册第五版》选用 KOYO 的 6011-Z 型号深沟球轴承（国内型号为 6011-Z）

得到’=31.2kN

代回寿命公式
ℎ =
10

6 60 × (

)

= 209.8ℎ (3.6)

满足设计要求。
3.2.2 右轴承选型
无冲击或轻微冲击 | 1.0～1.2
中等冲击或中等惯性冲击 | 1.2～1.8
强大冲击 | 1.8～3.0

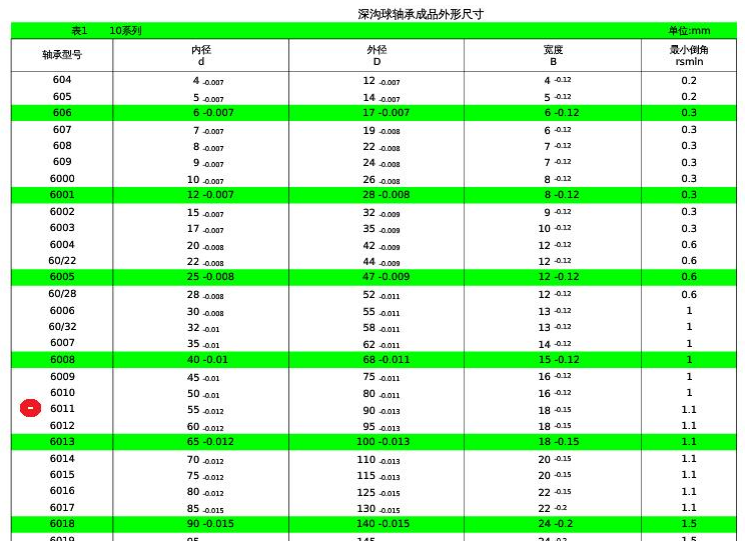
[picture p29: figure]

共 39 页 第 30 页

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
同上运用（3.1）中公式
得

P = 1.3 × 2101.49

2 + 719.46

2 = 2887.60

C=5.7kN
根据《机械设计手册第五版》选用 KOYO 的 6909 型号的深沟球轴承（国内型号为 61909）。
’=14.1kN, | ℎ =
10
6
60

× (

)

= 3170ℎ

满足设计要求。

3.3. 附录三 轴承公差

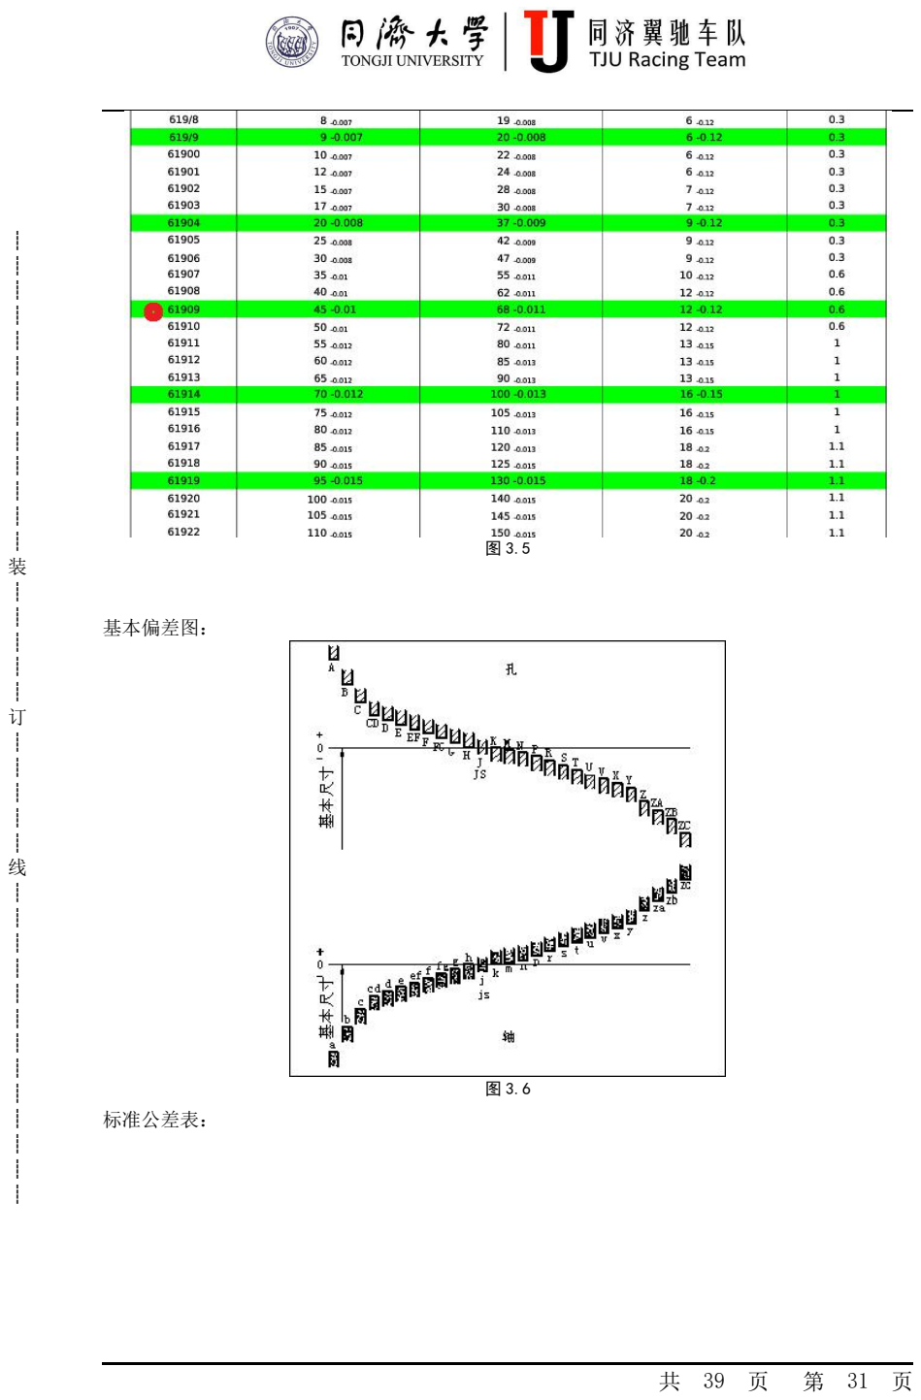
[picture p30: page 31]

共 39 页 | 第 31 页 ┊┊┊┊┊┊┊┊┊┊┊┊┊装┊┊┊┊┊订┊┊┊┊┊线┊┊┊┊┊┊┊┊┊┊┊┊┊ | 图 3.5 基本偏差图： | 图 3.6 标准公差表：

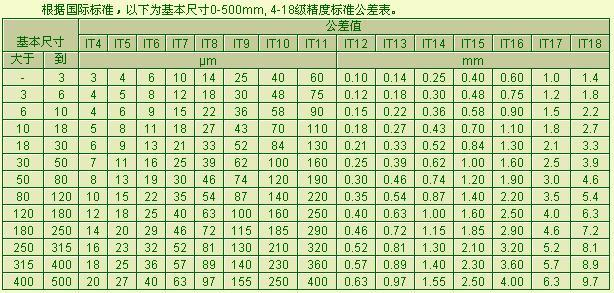
[picture p31: figure]
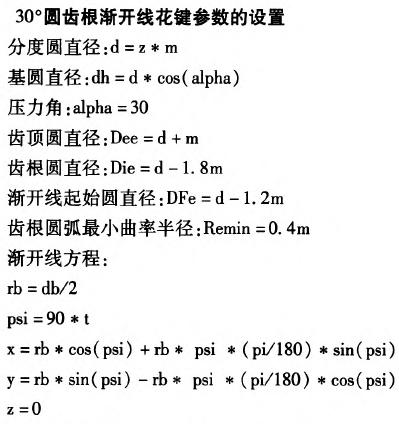
[picture p32: figure]

共 39 页 第 32 页

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
表 3.3

6011-Z 型号深沟球轴承（55

0
-0.012,90

0
-0.013）考虑阳极氧化厚度 0.05mm 并根据基本偏差图和标 准公差表将公差选择如下：
差速器与轴承配合处为 55

-0.01
-0.023 左支撑与轴承配合处为 900

0.022 61909 型号的深沟球轴承（45

0
-0.01，68

0
-0.011）
差速器与轴承配合处为 45

-0.009
-0.0256 右支撑与轴承配合处为 68

0.019
0 滑动轴承与差速器壳配合 H7/js6

滑动轴承内表面和球笼轴外表面表面粗糙度要求——Ra0.6 间隙要求 0.00075D=19.5μm 因而配合选为 G7/g8

3.4. 附录四 渐开线花键设计过程

图 3.7
软件计算过程：

共 39 页 第 33 页

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
花键类型： 外花键 | 齿 | 数： | 25
模 | 数： | 2 | 压 力 角： | 30 度
公 | 差： h | | 公差等级： | 6 级
配合长度： | 18MM | 分度圆直径（D）：50
基圆直径（Db）： 43.30127019 | 渐开线起始圆直径（Dfmax）：47.78116784
基本齿厚（S）：3.14159265 | 作用齿厚最大值（Svmax）：3.14159265
实际齿厚最小值（Smax）：3.10059265 实际齿厚最大值（Smin）：3.03259265 作用齿厚最小值（Svmin）：3.07359265
齿形公差（ff）：36 | 齿向公差（Fβ）：12
齿距累计公差（Fp）：57 | 综合公差（λ）：41
齿根圆弧最小曲率半径（Rmin）：0.4(平)0.8(圆)
制图：
画渐开线（描点，样条曲线拟合）
t | x | y
0 | 0 | 21.65064
0.05 0.027902 21.91609
| 0.085 | 0.136444 22.40886
0.1 0.221568 22.69283
0.13 0.483468 23.38166
0.16 0.893606 24.21542
0.17 1.068335 24.52164
0.18 1.263761 24.84044
| 0.185 | 1.369534 25.00424
0.19 1.480835 | 25.1708
| 0.195 | 1.597775 25.33999
0.2 1.720465 25.51167
0.21 1.983513 25.86192
0.22 2.270794 26.22041
| 0.23 | 2.58307 26.58596
0.24 2.921054 26.95731
| 0.245 | 3.099895 27.14478
0.25 3.285406 27.33322
| 0.255 | 3.477661 27.52246
| 0.26 | 3.67673 27.71236

花键建模结果如下：

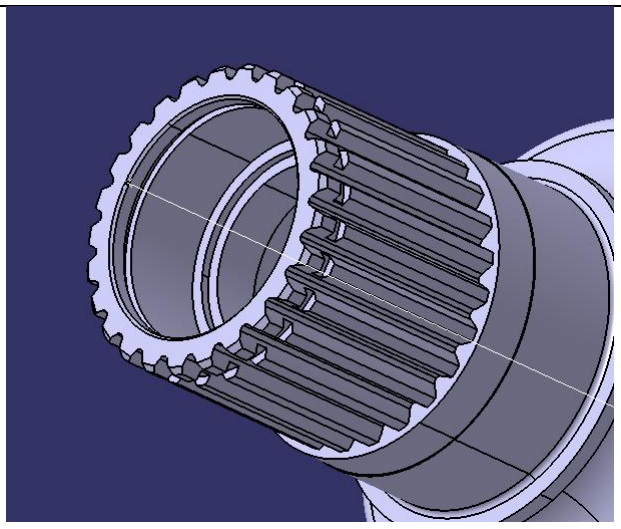
[picture p33: figure]

共 39 页 | 第 34 页 ┊┊┊┊┊┊┊┊┊┊┊┊┊装┊┊┊┊┊订┊┊┊┊┊线┊┊┊┊┊┊┊┊┊┊┊┊┊ | 图 3.8 3.5. 附录五 O 型圈选型以及沟槽设计标准 图 3.9

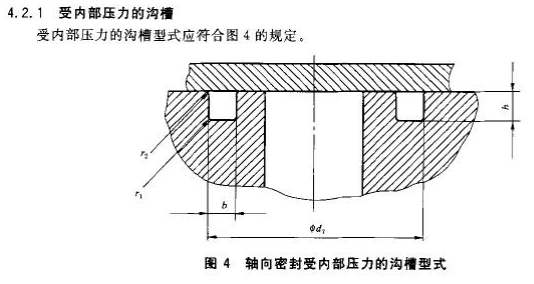
[picture p34: figure]

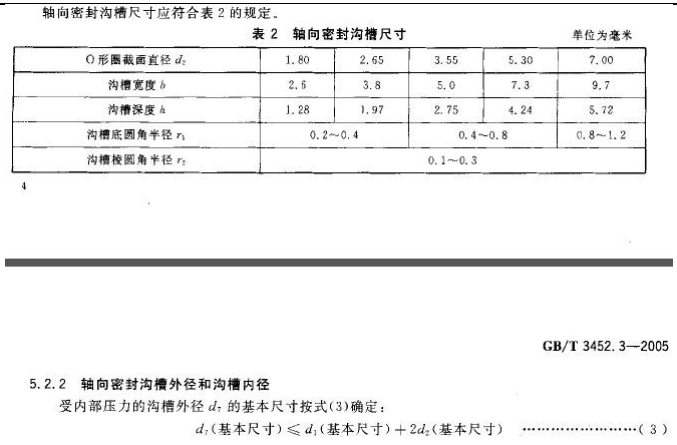
[picture p35: figure]

共 39 页 | 第 35 页 ┊┊┊┊┊┊┊┊┊┊┊┊┊装┊┊┊┊┊订┊┊┊┊┊线┊┊┊┊┊┊┊┊┊┊┊┊┊ | 图 3.10 3.6. 附录六 卡簧标准 | 表 3.4 轴用卡簧沟槽设计标准 图 3.11 孔用卡簧沟槽设计标准

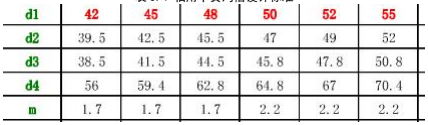
[picture p36: figure]

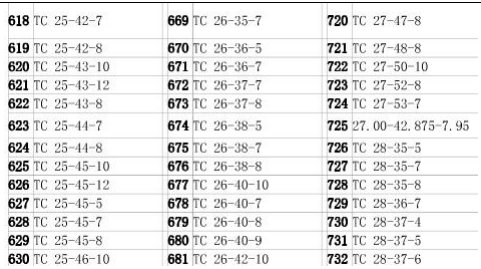
[picture p37: figure]

共 39 页 第 36 页

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
图 3.12 油封选型 TC 26-40-7 以及 TC 26-38-7

3.7.附录七 钛半轴扭转实验及其与钢半轴对比

3.7.1.实验目的

测量以及对比钛半轴和钢半轴扭转刚度和强度

3.7.2.实验器材

钛半轴：长度 425，实轴直径 20mm，花键端大径 22mm，小径 19.2mm 钢半轴：长度 425，实轴直径 20mm, 花键端大径 22mm, 小径 19.1mm 扭矩加载装置：最大扭矩可加 4000N.m。

3.7.3.实验过程

表 3.5 钢半轴实验数据
钢半轴
加载扭矩（N.m） | 加载时间（s） | 扭转角度（°） | 扭转刚度（N.m/rad）
0 | 0 | 4.217
0-500 | 100 | -6.151 | 2763.1
500-700 | 100 | -10.300 | 2761.9
700-900 | 100 | -22.550 | 935.4
900-1000 | 50 | -45.000 | 255.2

（卸载扭矩之后扭转角度为-23.176，已过屈服点）

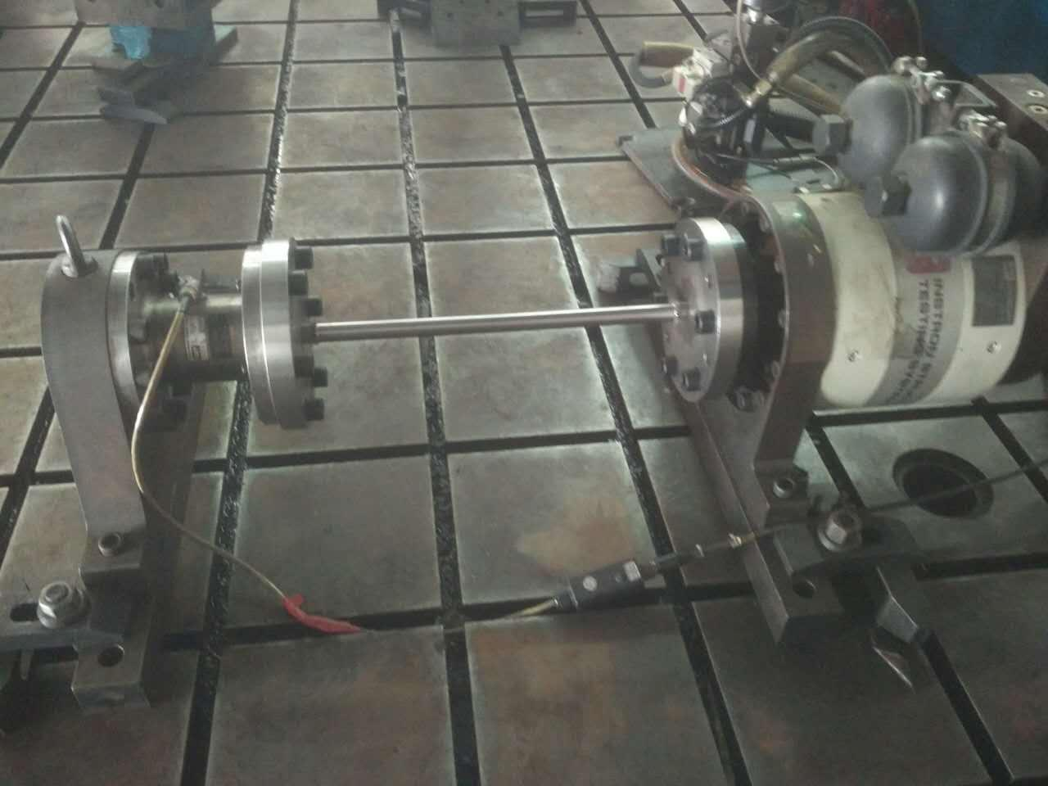
[picture p38: figure]

共 39 页 第 37 页

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
表 3.6 钛半轴实验数据
钛半轴
加载扭矩（N.m） | 加载时间（s） | 扭转角度（°） | 扭转刚度（N.m/rad）
0 | 0 | -0.915
0-500 | 100 | 17.003 | 1598.8
500-700 | 100 | 24.599 | 1508.6
700-900 | 100 | 35.258 | 1186.4
900-1000 | 50 | 43.828 | 668.56

图 3.1 半轴实验

3.7.4.实验结果分析

从实验结果来看，钢半轴刚度更好，快接近是钛的两倍。但随着扭矩加到 700-900N.m 这个 阶段，看出钢半轴的刚度大幅度的减少，以及发生塑性形变。可见钛半轴强度比钢要好。在我们

共 39 页 第 38 页

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
实际的比赛过程中，最大扭矩在 500N.m 左右，无论是使用钢半轴和钛半轴都不会过屈服点。钛 半轴可以满足我们实车要求。

共 39 页 第 39 页

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
## 参考文献

[1] 西北工业大学机械原理及机械零件教研室，机械设计（第九版）.北京：高等教 育 出版社,2013.5
[2] CUSCO LSD GUIDE.
[3]《三球销式万向节结构主参数的标准化与系列化设计_石宝枢》
