Lu-Chengyu/TR19/TR19_Cost_Report/TR19_CR_Part_Drawing/Chain.pdf

Chain | System | Engine & Drivetrain

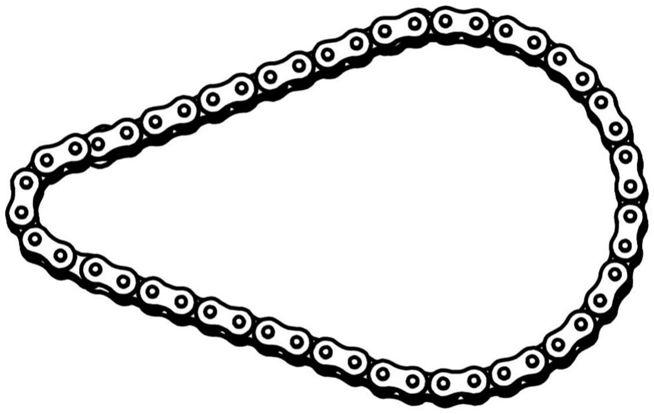
[picture p39: figure]

Materials | Steel,Alloy | Assembly | Chainwheel Assembly
Scale | 1:4
School | Tongji University | Number | 20093
Amount | 1
