Lu-Chengyu/TR19/TR19_Cost_Report/TR19_CR_Part_Drawing/Dust Fender.pdf

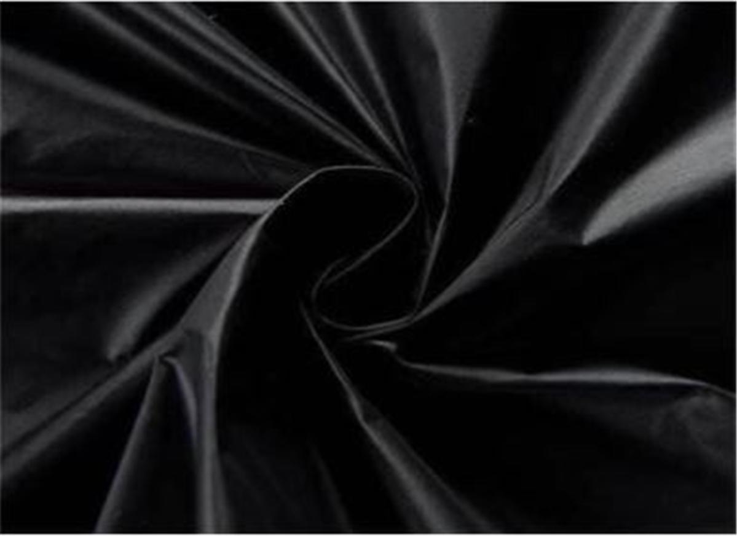
[picture p40: figure]

Dust Fender | System | Engine & Drivetrain
Materials | Fabric | Assembly | Axle Assembly
Scale | 1:1
School | Tongji University | Number | 20081
Amount | 4
