Lu-Chengyu/TR19/TR19_Cost_Report/TR19_CT_TS.xlsx

Sheet: Engine&Drivetrain
University | Tongji University |  |  |  |  |  |  |  | Car # | 003 |  | Sys Cost | $93.47
System | Engine&Drivetrain |  |  |  |  |  |  |  |  |  |  | Qty | 1
P/N Base |  |  |  |  |  |  |  |  | FileLink1
Suffix |  |  |  |  |  |  |  |  | FileLink2 |  |  | Extended Cost | $93.47
Details |  |  |  |  |  |  |  |  | FileLink3
ItemOrder | Assembly | Asm Cost | Quantity | Sub Total
AS8 | Chainwheel Assembly | $93.47 | 1 | $93.47
 |  |  | Sub Total | $93.47
ItemOrder | Material | Use | UnitCost | Size1 | Unit1 | Size2 | Unit2 | Area Name | Area | Length | Density | Quantity | Sub Total
 |  |  |  |  |  |  |  |  |  |  |  | Sub Total | $0.00
ItemOrder | Process | Use | UnitCost | Unit | Quantity | Multiplier | Mult. Val. | Sub Total
 |  |  |  |  |  |  | Sub Total | $0.00
ItemOrder | Fastener | Use | UnitCost | Size1 | Unit1 | Size2 | Unit2 | Quantity | Sub Total
 |  |  |  |  |  |  |  | Sub Total | $0.00
ItemOrder | Tooling | Use | UnitCost | Unit | Quantity | PVF | FractionIncluded | Sub Total
 |  |  |  |  |  |  | Sub Total | $0.00

Sheet: Chainwheel Assembly
University | Tongji University |  |  |  |  |  |  |  | Car # | 003 |  | Asm Cost | $93.47
System | Engine&Drivetrain |  |  |  |  |  |  |  |  |  |  | Qty | 1
Assembly | Chainwheel Assembly |  |  |  |  |  |  |  | FileLink1
P/N Base | A2009 |  |  |  |  |  |  |  | FileLink2 |  |  | Extended Cost | $93.47
Suffix | AA |  |  |  |  |  |  |  | FileLink3
Details | The Engine Power is Transmitted to the Differential Assembly.
ItemOrder | Part | Part Cost | Quantity | Sub Total
PA1 | Driven Chainwheel | $30.48 | 1 | $30.48
PA2 | Active Chainwheel | $13.46 | 1 | $13.46
PA3 | Chain | $38.10 | 1 | $38.10
PA4 | Chainwheel Tender | $4.66 | 1 | $4.66
PA5 | Chainwheel Washer | $6.77 | 1 | $6.77
 |  |  | Sub Total | $93.47
ItemOrder | Material | Use | UnitCost | Size1 | Unit1 | Size2 | Unit2 | Area Name | Area | Length | Density | Quantity | Sub Total
 | none |  |  |  |  |  |  |  |  |  |  |  | $0.00
 |  |  |  |  |  |  |  |  |  |  |  | Sub Total | $0.000
ItemOrder | Process | Use | UnitCost | Unit | Quantity | Multiplier | Mult. Val. | Sub Total
 | none |  |  |  |  |  |  | $0.00
 |  |  |  |  |  |  | Sub Total | $0.00
ItemOrder | Fastener | Use | UnitCost | Size1 | Unit1 | Size2 | Unit2 | Quantity | Sub Total
 | none |  |  |  |  |  |  |  | $0.00
 |  |  |  |  |  |  |  | Sub Total | $0.00
ItemOrder | Tooling | Use | UnitCost | Unit | Quantity | PVF | FractionIncluded | Sub Total
 | none |  |  |  |  |  |  | $0.00
 |  |  |  |  |  |  | Sub Total | $0.00

Sheet: Driven Chainwheel
University | Tongji University |  |  |  |  |  |  |  | Car # | 003 |  | Part Cost | $30.48
System | Engine&Drivetrain |  | FileLink1 |  |  |  |  |  |  |  |  | Qty | 1
Assembly | Chainwheel Assembly |  | FileLink2 |  |  |  |  |  | FileLink1
Part | Driven Chainwheel |  | FileLink3 |  |  |  |  |  | FileLink2 |  |  | Extended Cost | $30.48
P/N Base | 20091 |  |  |  |  |  |  |  | FileLink3
Suffix | AA
Details | Deceleration to Increase Torque
ItemOrder | Material | Use | UnitCost | Size1 | Unit1 | Size2 | Unit2 | Area Name | Area | Length | Density | Quantity | Sub Total
MA1 | Aluminum, Normal | Used for Driven Chainwheel | $4.2 | 202 | mm |  |  | Round Φ202 | 32031.14 | 20.00 | 2.81e-06 | 1 | $7.56
 |  |  |  |  |  |  |  |  |  |  |  | Sub Total | $7.561
ItemOrder | Process | Use | UnitCost | Unit | Quantity | Multiplier | Mult. Val. | Sub Total
PR1 | Machining Setup, Install and remove | Preparation for CNC | $1.30 | unit | 1 |  |  | $1.30
PR2 | Machining | Miling outer contour | $0.04 | cm^3 | 200.96 | Material - Aluminum | 1 | $8.04
PR3 | Machining Setup, Change | Change side | $0.65 | unit | 1 |  |  | $0.65
PR4 | Machining | Miling outer contour and inner contour | $0.04 | cm^3 | 323.15 | Material - Aluminum | 1 | $12.93
PR8 | Anodize | Increase surface hardness | $0.00 | unit |  |  |  | $0.00
 |  |  |  |  |  |  | Sub Total | $22.91
ItemOrder | Fastener | Use | UnitCost | Size1 | Unit1 | Size2 | Unit2 | Quantity | Sub Total
 | none |  |  |  |  |  |  |  | $0.00
 |  |  |  |  |  |  |  | Sub Total | $0.00
ItemOrder | Tooling | Use | UnitCost | Unit | Quantity | PVF | FractionIncluded | Sub Total
 | none |  |  |  |  |  |  | $0.00
 |  |  |  |  |  |  | Sub Total | $0.00

Sheet: Active Chainwheel
University | Tongji University |  |  |  |  |  |  |  | Car # | 003 |  | Part Cost | $13.46
System | Engine&Drivetrain |  | FileLink1 |  |  |  |  |  |  |  |  | Qty | 1
Assembly | Chainwheel Assembly |  | FileLink2 |  |  |  |  |  | FileLink1
Part | Active Chainwheel |  | FileLink3 |  |  |  |  |  | FileLink2 |  |  | Extended Cost | $13.46
P/N Base | 20092 |  |  |  |  |  |  |  | FileLink3
Suffix | AA
Details | Output Torque
ItemOrder | Material | Use | UnitCost | Size1 | Unit1 | Size2 | Unit2 | Area Name | Area | Length | Density | Quantity | Sub Total
MA1 | Steel,Alloy | Used for Active Chainwheel | $2.25 | 65 | mm |  |  | Round Φ65 | 3316.625 | 10.00 | 7.85e-06 | 1 | $0.59
 |  |  |  |  |  |  |  |  |  |  |  | Sub Total | $0.586
ItemOrder | Process | Use | UnitCost | Unit | Quantity | Multiplier | Mult. Val. | Sub Total
PR1 | Heat Treatment | Heat Treatment in advance | $0.00 | unit | 1 |  |  | $0.00
PR2 | Machining Setup, Install and remove | Preparation for CNC | $1.30 | unit | 1 |  |  | $1.30
PR3 | Machining | Miling outer contour | $0.04 | cm^3 | 13.05 | Material - Steel | 3 | $1.57
PR4 | Machining Setup, Change | Change side | $0.65 | unit | 1 |  |  | $0.65
PR5 | Machining | Miling outer contour | $0.04 | cm^3 | 7.47 | Material - Steel | 3 | $0.90
PR6 | Machining Setup, Install and remove | Preparation for drill | $1.30 | unit | 1 |  |  | $1.30
PR7 | Drilled holes < 25.4 mm dia. | Drill Φ5 hole | $0.35 | hole | 1 |  |  | $0.35
PR8 | Machining Setup, Install and remove | Preparation for EDM | $1.30 | unit | 1 |  |  | $1.30
PR9 | EDM - Wire | Cut Spline | $0.20 | cm | 9.18 | Material - Steel | 3 | $5.51
 |  |  |  |  |  |  | Sub Total | $12.87
ItemOrder | Fastener | Use | UnitCost | Size1 | Unit1 | Size2 | Unit2 | Quantity | Sub Total
 | none |  |  |  |  |  |  |  | $0.00
 |  |  |  |  |  |  |  | Sub Total | $0.00
ItemOrder | Tooling | Use | UnitCost | Unit | Quantity | PVF | FractionIncluded | Sub Total
 | none |  |  |  |  |  |  | $0.00
 |  |  |  |  |  |  | Sub Total | $0.00

Sheet: Chain
University | Tongji University |  |  |  |  |  |  |  | Car # | 003 |  | Part Cost | $38.10
System | Engine&Drivetrain |  | FileLink1 |  |  |  |  |  |  |  |  | Qty | 1
Assembly | Chainwheel Assembly |  | FileLink2 |  |  |  |  |  | FileLink1
Part | Chain |  | FileLink3 |  |  |  |  |  | FileLink2 |  |  | Extended Cost | $38.10
P/N Base | 20093 |  |  |  |  |  |  |  | FileLink3
Suffix | AA
Details | Transfer power
ItemOrder | Material | Use | UnitCost | Size1 | Unit1 | Size2 | Unit2 | Area Name | Area | Length | Density | Quantity | Sub Total
MA1 | Chain | Used for transfer power | $0.05 |  | mm |  |  |  |  |  |  | 762 | $38.10
 |  |  |  |  |  |  |  |  |  |  |  | Sub Total | $38.100
ItemOrder | Process | Use | UnitCost | Unit | Quantity | Multiplier | Mult. Val. | Sub Total
 | none |  |  |  |  |  |  | $0.00
 |  |  |  |  |  |  | Sub Total | $0.00
ItemOrder | Fastener | Use | UnitCost | Size1 | Unit1 | Size2 | Unit2 | Quantity | Sub Total
 | none |  |  |  |  |  |  |  | $0.00
 |  |  |  |  |  |  |  | Sub Total | $0.00
ItemOrder | Tooling | Use | UnitCost | Unit | Quantity | PVF | FractionIncluded | Sub Total
 | none |  |  |  |  |  |  | $0.00
 |  |  |  |  |  |  | Sub Total | $0.00

Sheet: Chainwheel Tender
University | Tongji University |  |  |  |  |  |  |  | Car # | 003 |  | Part Cost | $4.66
System | Engine&Drivetrain |  | FileLink1 |  |  |  |  |  |  |  |  | Qty | 1
Assembly | Chainwheel Assembly |  | FileLink2 |  |  |  |  |  | FileLink1
Part | Chainwheel Tender |  | FileLink3 |  |  |  |  |  | FileLink2 |  |  | Extended Cost | $4.66
P/N Base | 20094 |  |  |  |  |  |  |  | FileLink3
Suffix | AA
Details | Protect Chainwheel Assembly
ItemOrder | Material | Use | UnitCost | Size1 | Unit1 | Size2 | Unit2 | Area Name | Area | Length | Density | Quantity | Sub Total
MA1 | Steel,Alloy | Used for Chainwheel Tender | $2.25 | 66 | mm | 424 | mm | Plate 66*424 | 27984 | 2.66 | 7.85e-06 | 1 | $1.31
 |  |  |  |  |  |  |  |  |  |  |  | Sub Total | $1.315
ItemOrder | Process | Use | UnitCost | Unit | Quantity | Multiplier | Mult. Val. | Sub Total
PR1 | Sheet metal shearing | Processing chainwheel baffle outer contour | $0.25 | cut | 3 |  |  | $0.75
PR2 | Machining Setup, Install and remove | Preparation for drill | $1.30 | unit | 1 |  |  | $1.30
PR2 | Drilled holes < 25.4 mm dia. | Drill Φ6 hole | $0.35 | hole | 3 |  |  | $1.05
PR3 | Sheet metal bends | Processing baffle shape | $0.25 | bend | 1 |  |  | $0.25
 |  |  |  |  |  |  | Sub Total | $3.35
ItemOrder | Fastener | Use | UnitCost | Size1 | Unit1 | Size2 | Unit2 | Quantity | Sub Total
 | none |  |  |  |  |  |  |  | $0.00
 |  |  |  |  |  |  |  | Sub Total | $0.00
ItemOrder | Tooling | Use | UnitCost | Unit | Quantity | PVF | FractionIncluded | Sub Total
 | none |  |  |  |  |  |  | $0.00
 |  |  |  |  |  |  | Sub Total | $0.00

Sheet: Chainwheel Washer
University | Tongji University |  |  |  |  |  |  |  | Car # | 003 |  | Part Cost | $6.77
System | Engine&Drivetrain |  | FileLink1 |  |  |  |  |  |  |  |  | Qty | 1
Assembly | Chainwheel Assembly |  | FileLink2 |  |  |  |  |  | FileLink1
Part | Chainwheel Washer |  | FileLink3 |  |  |  |  |  | FileLink2 |  |  | Extended Cost | $6.77
P/N Base | 20095 |  |  |  |  |  |  |  | FileLink3
Suffix | AA
Details | Adjust the Gap
ItemOrder | Material | Use | UnitCost | Size1 | Unit1 | Size2 | Unit2 | Area Name | Area | Length | Density | Quantity | Sub Total
MA1 | Aluminum,Premium | Used for Chainwheel Washer | $4.2 | 65 | mm |  |  | Round Φ65 | 3316.625 | 13.00 | 2.81e-06 | 1 | $0.51
 |  |  |  |  |  |  |  |  |  |  |  | Sub Total | $0.509
ItemOrder | Process | Use | UnitCost | Unit | Quantity | Multiplier | Mult. Val. | Sub Total
PR1 | Machining Setup, Install and remove | Preparation for machining | $1.30 | unit | 1 |  |  | $1.30
PR2 | Machining | Lathing outer contour | $0.04 | cm^3 | 0.18 | Material - Aluminum | 1 | $0.01
PR3 | Machining Setup, Change | Change side | $0.65 | unit | 1 |  |  | $0.65
PR4 | Machining | Lathing outer contour | $0.04 | cm^3 | 0.17 | Material - Aluminum | 1 | $0.01
PR5 | Machining Setup, Install and remove | Preparation for drill | $1.30 | unit | 1 |  |  | $1.30
PR6 | Drilled holes <25.4 mm dia | Drill Φ10 hole | $0.35 | hole | 1 |  |  | $0.35
PR7 | Machining Setup, Install and remove | Preparation for EDM | $1.30 | unit | 1 |  |  | $1.30
PR8 | EDM-Wire | Cut spline | $0.20 | cm | 1.56 | Material - Aluminum | 1 | $0.31
PR9 | Machining Setup, Change | Change side | $0.65 | unit | 1 |  |  | $0.65
PR10 | EDM-Wire | Cut to 4 pieses | $0.20 | cm | 1.94 | Material - Aluminum | 1 | $0.39
 |  |  |  |  |  |  | Sub Total | $6.26
ItemOrder | Fastener | Use | UnitCost | Size1 | Unit1 | Size2 | Unit2 | Quantity | Sub Total
 | none |  |  |  |  |  |  |  | $0.00
 |  |  |  |  |  |  |  | Sub Total | $0.00
ItemOrder | Tooling | Use | UnitCost | Unit | Quantity | PVF | FractionIncluded | Sub Total
 | none |  |  |  |  |  |  | $0.00
 |  |  |  |  |  |  | Sub Total | $0.00

Sheet: Tripod Shaft_L
University | Tongji University |  |  |  |  |  |  |  | Car # | 003 |  | Part Cost | $57.68
System | Engine&Drivetrain |  | FileLink1 |  |  |  |  |  |  |  |  | Qty | 1
Assembly | Chainwheel Assembly |  | FileLink2 |  |  |  |  |  | FileLink1
Part | Tripod Shaft_L |  | FileLink3 |  |  |  |  |  | FileLink2 |  |  | Extended Cost | $57.68
P/N Base | 200712 |  |  |  |  |  |  |  | FileLink3
Suffix | AA
Details | Connecting Axles and Differentials
ItemOrder | Material | Use | UnitCost | Size1 | Unit1 | Size2 | Unit2 | Area Name | Area | Length | Density | Quantity | Sub Total
MA1 | Steel, Alloy | Used for Tripod Shaft_L | $2.25 | 61 | mm |  |  | Round Φ61 | 2920.985 | 152.00 | 7.85e-06 | 1 | $7.84
 |  |  |  |  |  |  |  |  |  |  |  | Sub Total | $7.842
ItemOrder | Process | Use | UnitCost | Unit | Quantity | Multiplier | Mult. Val. | Sub Total
PR1 | Heat Treatment | Heat Treatment in advance | $0.00 | unit | 1 |  |  | $0.00
PR2 | Machining Setup, Install and remove | Preparation for machining | $1.30 | unit | 1 |  |  | $1.30
PR3 | Machining | Lathing outer contour | $0.04 | cm^3 | 288.77 | Material - Steel | 3 | $34.65
PR4 | Machining Setup, Change | Change side | $0.65 | unit | 1 |  |  | $0.65
PR5 | Machining | Lathing hole | $0.04 | cm^3 | 38.29 | Material - Steel | 3 | $4.59
PR6 | Machining Setup, Install and remove | Preparation for EDM | $1.30 | unit | 1 |  |  | $1.30
PR7 | EDM - Plunge | Milling Spline | $0.30 | cm^3 | 1.72 | Material - Steel | 3 | $1.55
PR8 | Machining Setup, Install and remove | Preparation for CNC | $1.30 | unit | 1 |  |  | $1.30
PR9 | Machining | Milling ball cage | $0.04 | cm^3 | 37.44 | Material - Steel | 3 | $4.49
 |  |  |  |  |  |  | Sub Total | $49.84
ItemOrder | Fastener | Use | UnitCost | Size1 | Unit1 | Size2 | Unit2 | Quantity | Sub Total
 | none |  |  |  |  |  |  |  | $0.00
 |  |  |  |  |  |  |  | Sub Total | $0.00
ItemOrder | Tooling | Use | UnitCost | Unit | Quantity | PVF | FractionIncluded | Sub Total
 | none |  |  |  |  |  |  | $0.00
 |  |  |  |  |  |  | Sub Total | $0.00

Sheet: Tripod Shaft_R
University | Tongji University |  |  |  |  |  |  |  | Car # | 003 |  | Part Cost | $51.60
System | Engine&Drivetrain |  | FileLink1 |  |  |  |  |  |  |  |  | Qty | 1
Assembly | Chainwheel Assembly |  | FileLink2 |  |  |  |  |  | FileLink1
Part | Tripod Shaft_R |  | FileLink3 |  |  |  |  |  | FileLink2 |  |  | Extended Cost | $51.60
P/N Base | 200713 |  |  |  |  |  |  |  | FileLink3
Suffix | AA
Details | Connecting Axles and Differentials
ItemOrder | Material | Use | UnitCost | Size1 | Unit1 | Size2 | Unit2 | Area Name | Area | Length | Density | Quantity | Sub Total
MA1 | Steel, Alloy | Used for Tripod Shaft_R | $2.25 | 61 | mm |  |  | Round Φ61 | 2920.985 | 135.00 | 7.85e-06 | 1 | $6.96
 |  |  |  |  |  |  |  |  |  |  |  | Sub Total | $6.965
ItemOrder | Process | Use | UnitCost | Unit | Quantity | Multiplier | Mult. Val. | Sub Total
PR1 | Heat Treatment | Heat Treatment in advance | $0.00 | unit | 1 |  |  | $0.00
PR2 | Machining Setup, Install and remove | Preparation for machining | $1.30 | unit | 1 |  |  | $1.30
PR3 | Machining | Lathing outer contour | $0.04 | cm^3 | 246.4 | Material - Steel | 3 | $29.57
PR4 | Machining Setup, Change | Change side | $0.65 | unit | 1 |  |  | $0.65
PR5 | Machining | Lathing hole | $0.04 | cm^3 | 37.32 | Material - Steel | 3 | $4.48
PR6 | Machining Setup, Install and remove | Preparation for EDM | $1.30 | unit | 1 |  |  | $1.30
PR7 | EDM - Plunge | Milling Spline | $0.30 | cm^3 | 1.72 | Material - Steel | 3 | $1.55
PR8 | Machining Setup, Install and remove | Preparation for CNC | $1.30 | unit | 1 |  |  | $1.30
PR9 | Machining | Milling ball cage | $0.04 | cm^3 | 37.44 | Material - Steel | 3 | $4.49
 |  |  |  |  |  |  | Sub Total | $44.64
ItemOrder | Fastener | Use | UnitCost | Size1 | Unit1 | Size2 | Unit2 | Quantity | Sub Total
 | none |  |  |  |  |  |  |  | $0.00
 |  |  |  |  |  |  |  | Sub Total | $0.00
ItemOrder | Tooling | Use | UnitCost | Unit | Quantity | PVF | FractionIncluded | Sub Total
 | none |  |  |  |  |  |  | $0.00
 |  |  |  |  |  |  | Sub Total | $0.00

Sheet: Apron Bracket
University | Tongji University |  |  |  |  |  |  |  | Car # | 003 |  | Part Cost | $8.25
System | Frame&Body |  | FileLink1 |  |  |  |  |  |  |  |  | Qty | 3
Assembly | Frame |  | FileLink2 |  |  |  |  |  | FileLink1
Part | Apron Bracket |  | FileLink3 |  |  |  |  |  | FileLink2 |  |  | Extended Cost | $24.76
P/N Base |  |  |  |  |  |  |  |  | FileLink3
Suffix | AA
Details
ItemOrder | Material | Use | UnitCost | Size1 | Unit1 | Size2 | Unit2 | Area Name | Area | Length | Density | Quantity | Sub Total
MA1 | Steel, Alloy | Used for Apron Bracket | $2.25 | 25 | mm | 30 | mm | Plate 25*30 | 750 | 3.00 | 7.85e-06 | 1.00 | $0.04
 |  |  |  |  |  |  |  |  |  |  |  | Sub Total | $0.04
ItemOrder | Process | Use | UnitCost | Unit | Quantity | Multiplier | Mult. Val. | Sub Total
PR1 | Heat Treatment | Heat Treatment in advance | $0.00 | unit | 1 |  |  | $0.00
PR2 | Machining Setup, Install and remove | Preparation for EDM | $1.30 | unit | 1 |  |  | $1.30
PR3 | EDM-Wire | Cut off | $0.20 | cm | 8.77 | Material - Steel | 3 | $5.26
PR4 | Machining Setup, Install and remove | Preparation for drill | $1.30 | unit | 1 |  |  | $1.30
PR5 | Drilled holes < 25.4 mm dia. | Drill Φ6 hole | $0.35 | hole | 1 |  |  | $0.35
 |  |  |  |  |  |  | Sub Total | $8.21
ItemOrder | Fastener | Use | UnitCost | Size1 | Unit1 | Size2 | Unit2 | Quantity | Sub Total
 | none |  |  |  |  |  |  |  | $0.00
 |  |  |  |  |  |  |  | Sub Total | $0.00
ItemOrder | Tooling | Use | UnitCost | Unit | Quantity | PVF | FractionIncluded | Sub Total
 | none |  |  |  |  |  |  | $0.00
 |  |  |  |  |  |  | Sub Total | $0.00

Sheet: Cage Housing Sleeve
University | Tongji University |  |  |  |  |  |  |  | Car # | 003 |  | Part Cost | $30.51
System | Wheels,Wheel Bearings and Tires |  | FileLink1 |  |  |  |  |  |  |  |  | Qty | 2
Assembly | Rear Hubs |  | FileLink2 |  |  |  |  |  | FileLink1
Part | Cage Housing Sleeve |  | FileLink3 |  |  |  |  |  | FileLink2 |  |  | Extended Cost | $61.02
P/N Base | 80028 |  |  |  |  |  |  |  | FileLink3
Suffix | AA
Details | 5
ItemOrder | Material | Use | UnitCost | Size1 | Unit1 | Size2 | Unit2 | Area Name | Area | Length | Density | Quantity | Sub Total
MA1 | Steel, Alloy | Used for Cage Housing Sleeve | $2.25 | 66 | mm | 33 | mm | Round Φ66 | 3419.46 | 37.00 | 7.85e-06 | 1 | $2.23
 |  |  |  |  |  |  |  |  |  |  |  | Sub Total | $2.23
ItemOrder | Process | Use | UnitCost | Unit | Quantity | Multiplier | Mult. Val. | Sub Total
PR1 | Machining Setup, Install and remove | Wire-electrode cutting ready | $1.30 | unit | 1 |  |  | $1.30
PR2 | EDM - Wire | Wire-electrode cutting outside outline form | $0.20 | cm | 19.25 | Material - Steel | 3 | $11.55
PR3 | Machining Setup, Change | Wire-electrode cutting ready | $1.30 | unit | 1 |  |  | $1.30
PR4 | EDM - Wire | Wire-electrode cutting inside outline form | $0.20 | cm | 17.46 | Material - Steel | 3 | $10.48
PR5 | Machining Setup, Change | Wire-electrode cutting surface change | $0.65 | unit | 1 |  |  | $0.65
PR6 | EDM - Wire | Separate two components | $0.20 | cm | 5 | Material - Steel | 3 | $3.00
 |  |  |  |  |  |  | Sub Total | $28.28
ItemOrder | Fastener | Use | UnitCost | Size1 | Unit1 | Size2 | Unit2 | Quantity | Sub Total
 | none |  |  |  |  |  |  |  | $0.00
 |  |  |  |  |  |  |  | Sub Total | $0.00
ItemOrder | Tooling | Use | UnitCost | Unit | Quantity | PVF | FractionIncluded | Sub Total
 | none |  |  |  |  |  |  | $0.00
 |  |  |  |  |  |  | Sub Total | $0.00
