Lu-Chengyu/TR19/TR19_Part/Tripod Shaft_L.stp

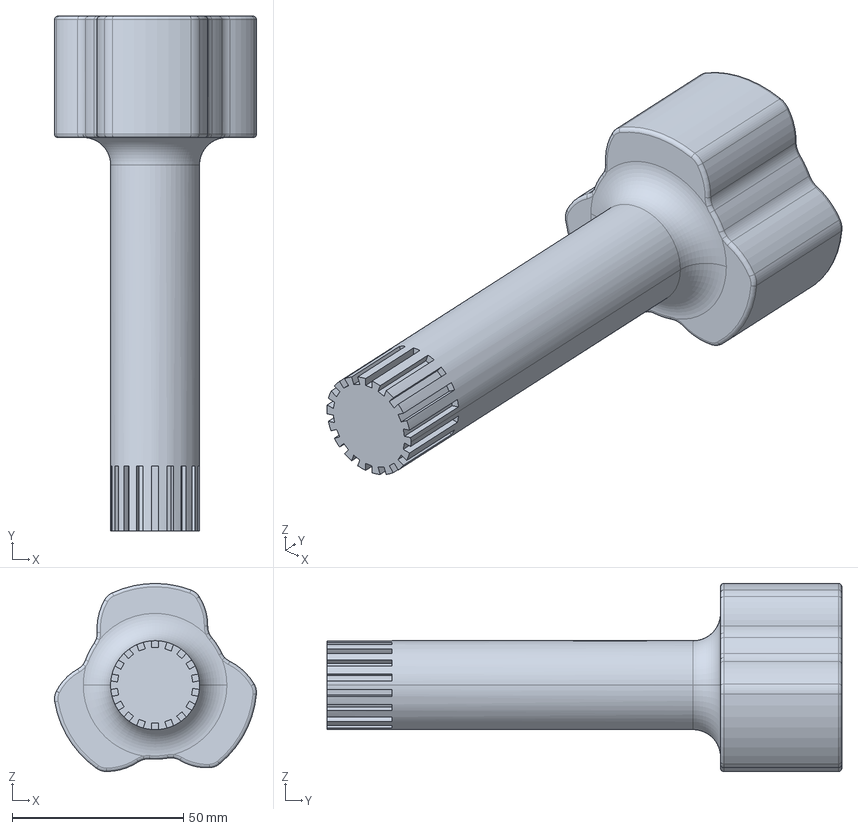
[picture p41: CAD file, 2024-06-22]
TR19_Part/Tripod Shaft_L.stp
59.1 x 150.5 x 55.0 mm
