Lu-Chengyu/TR19/TR19_Part/Cusco.stp

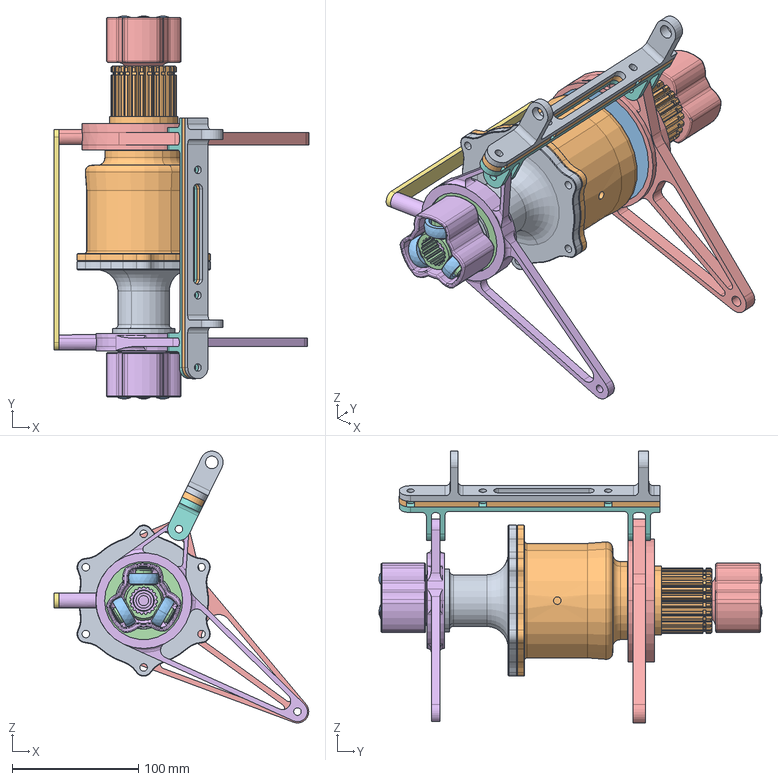
[picture p42: CAD file, 2024-06-22]
TR19_Part/Cusco.stp
202.1 x 303.9 x 215.6 mm
