Lu-Chengyu/TR19/TR19_Part/Chainwheel Tender.stp

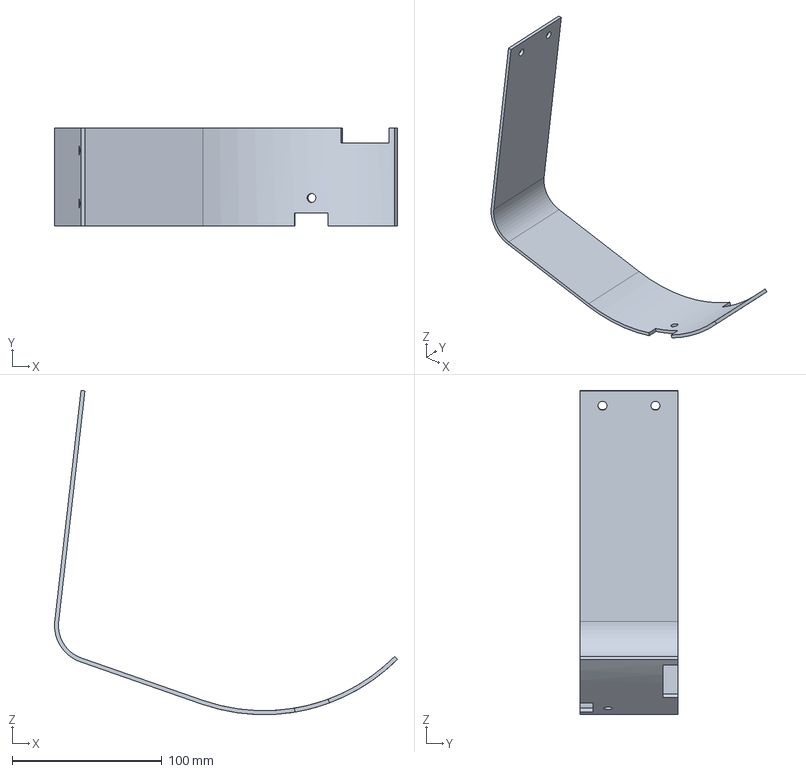
[picture p43: CAD file, 2024-06-22]
TR19_Part/Chainwheel Tender.stp
229.2 x 65.4 x 216.6 mm
