Lu-Chengyu/TR19/TR19_Part/Cusco Shell_L.stp

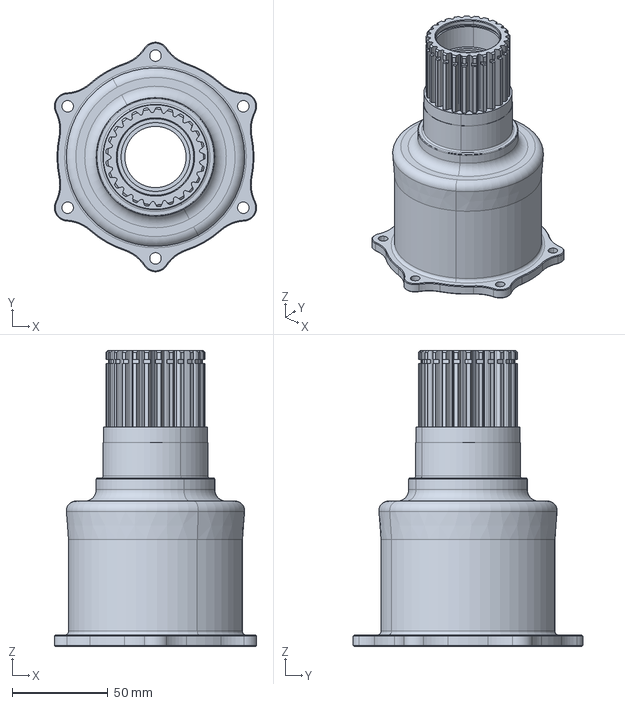
[picture p44: CAD file, 2024-06-22]
TR19_Part/Cusco Shell_L.stp
105.8 x 120.0 x 154.7 mm
