Lu-Chengyu/TR19/TR19_Part/Active Chainwheel.stp

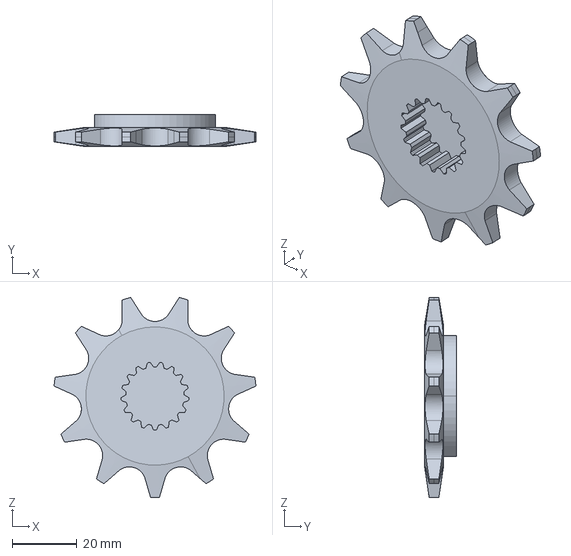
[picture p45: CAD file, 2024-06-22]
TR19_Part/Active Chainwheel.stp
62.3 x 10.0 x 61.7 mm
