Lu-Chengyu/TR19/TR19_Part/Support_L.stp

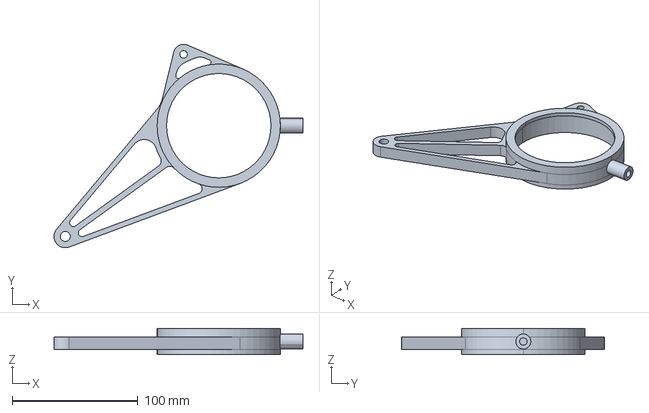
[picture p46: CAD file, 2024-06-22]
TR19_Part/Support_L.stp
198.0 x 161.8 x 21.0 mm
