Lu-Chengyu/TR19/TR19_Part/Tripod Shaft_R.stp

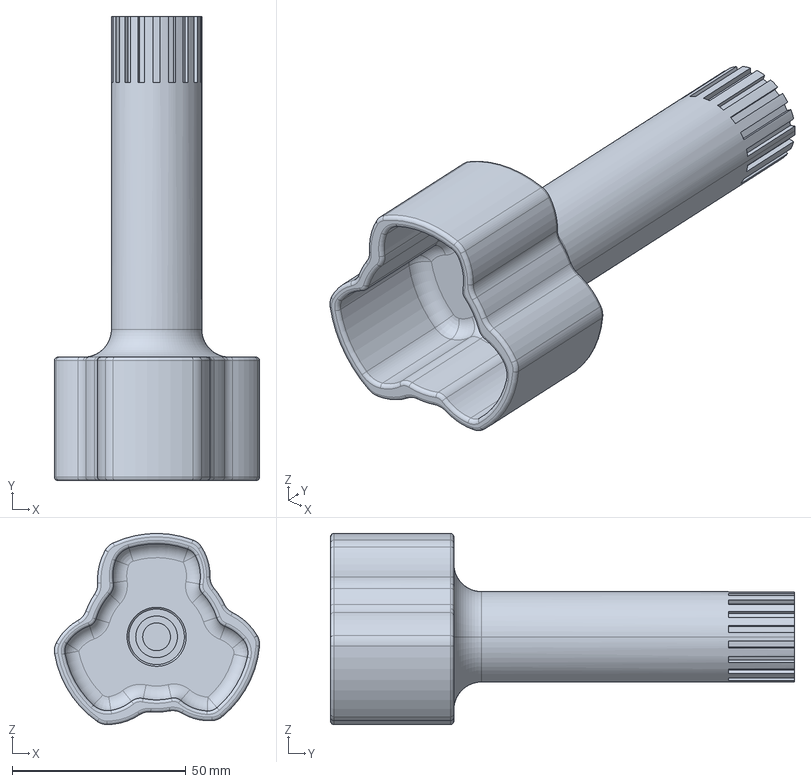
[picture p47: CAD file, 2024-06-22]
TR19_Part/Tripod Shaft_R.stp
59.1 x 133.5 x 55.0 mm
