Lu-Chengyu/TR19/TR19_Part/Apron Lifting Lug.stp

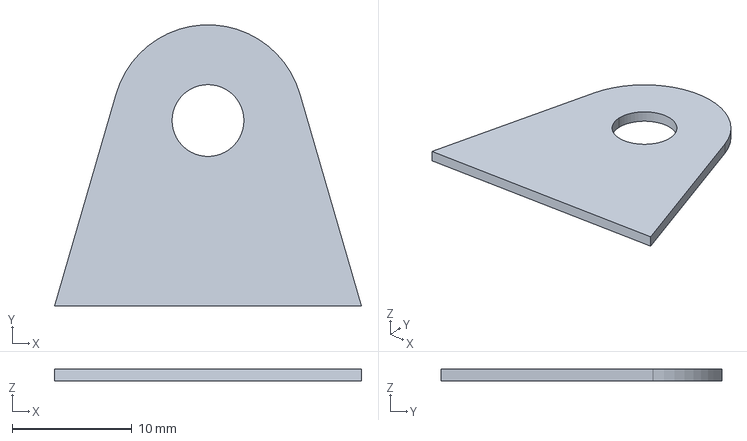
[picture p48: CAD file, 2024-06-22]
TR19_Part/Apron Lifting Lug.stp
25.7 x 23.5 x 1.00 mm
