Lu-Chengyu/TR19/TR19_Part/Cusco Shell_R.stp

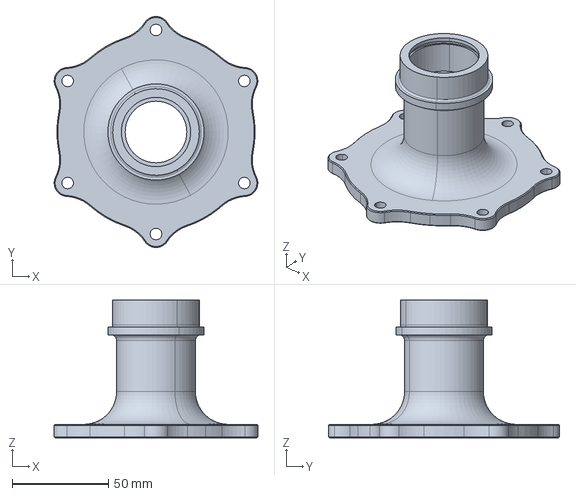
[picture p49: CAD file, 2024-06-22]
TR19_Part/Cusco Shell_R.stp
105.8 x 120.0 x 71.5 mm
