Lu-Chengyu/TR19/TR19_Part/Limiting Bar.stp

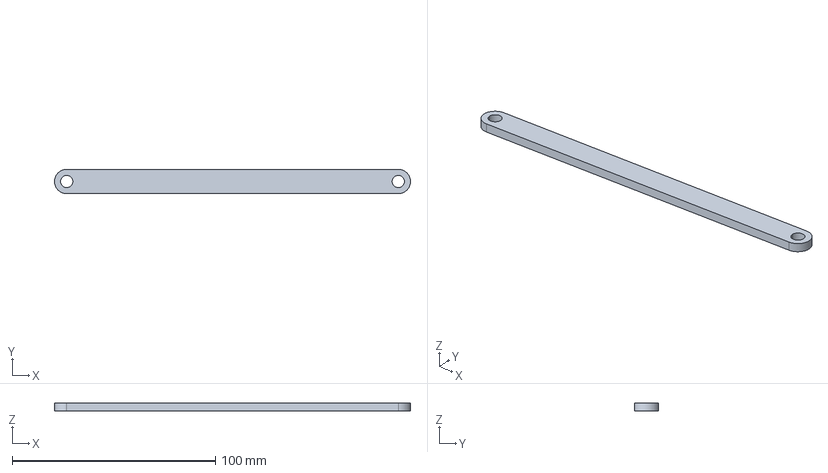
[picture p50: CAD file, 2024-06-22]
TR19_Part/Limiting Bar.stp
175.0 x 12.0 x 4.00 mm
