Lu-Chengyu/TR19/TR19_Part/Chainwheel.stp

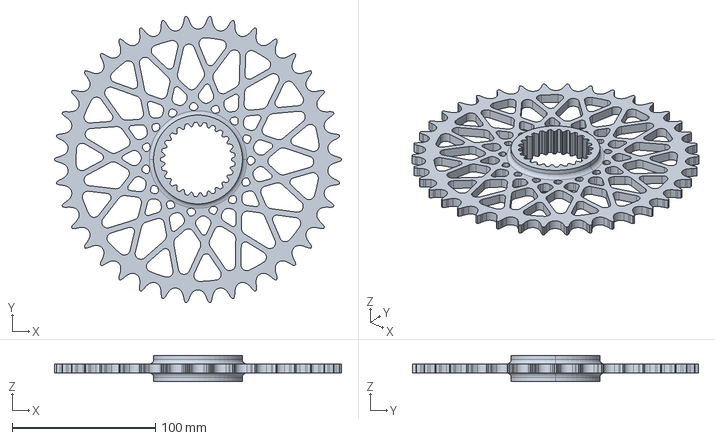
[picture p51: CAD file, 2024-06-22]
TR19_Part/Chainwheel.stp
200.2 x 199.6 x 18.2 mm
