Lu-Chengyu/TR19/TR19_Part/Rear Hausing Sleeve.stp

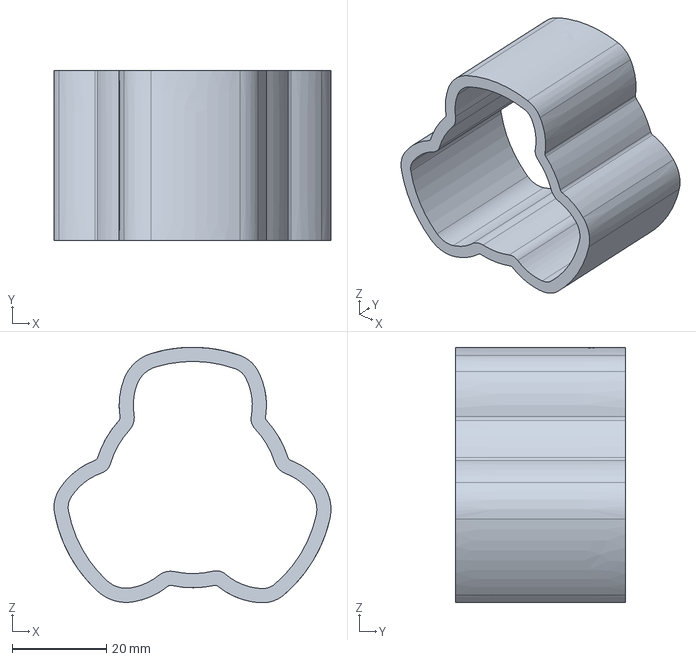
[picture p52: CAD file, 2024-06-22]
TR19_Part/Rear Hausing Sleeve.stp
58.7 x 36.0 x 54.1 mm
