Lu-Chengyu/TR19/TR19_Part/Support_R.stp

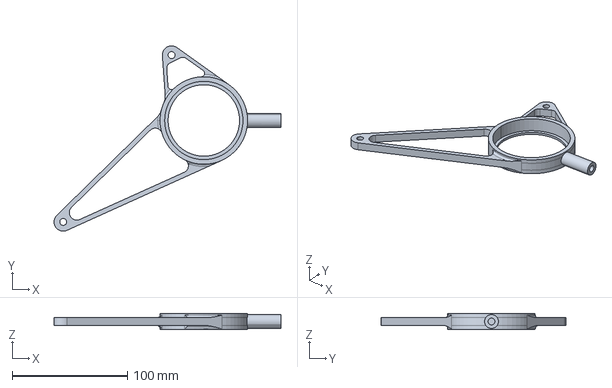
[picture p53: CAD file, 2024-06-22]
TR19_Part/Support_R.stp
197.0 x 160.8 x 14.0 mm
