Lu-Chengyu/TR19/TR19_Part/Chainwheel Washer.stp

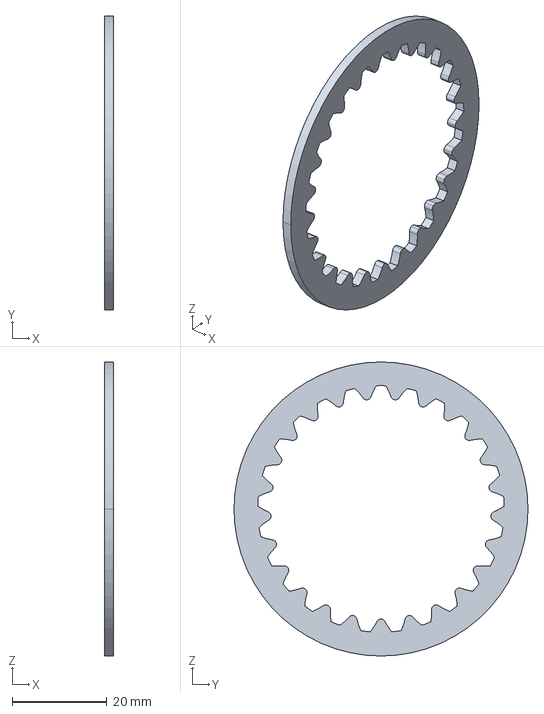
[picture p54: CAD file, 2024-06-22]
TR19_Part/Chainwheel Washer.stp
2.00 x 62.0 x 62.0 mm
