Lu-Chengyu/TR19/(list of files, cad)

Other CAD files:
TR19_Part/TR19.stp
