Lu-Chengyu/TR19/TR19_Cost_Report/TR19_CR_Part_Drawing/Axle Assembly.pdf

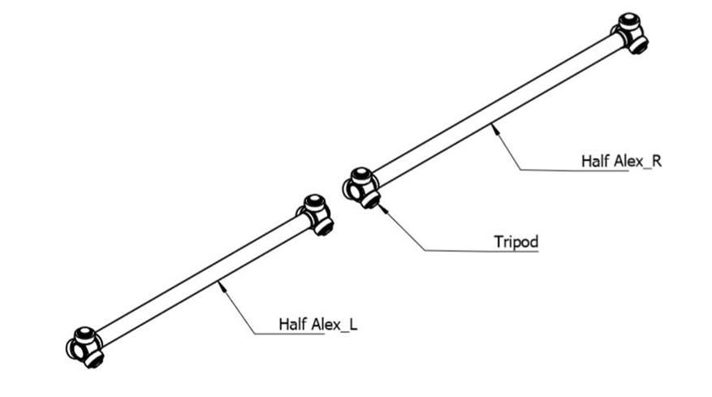
[picture p55: figure]

Axle Assembly | System | Engine & Drivetrain
Materials | | Assembly | Axle Assembly
Scale | 1:4
School | Tongji University | Number | A2008
Amount | 1
