Lu-Chengyu/TR19/TR19_Cost_Report/TR19_CR_Part_Drawing/Chainwheel Assembly.pdf

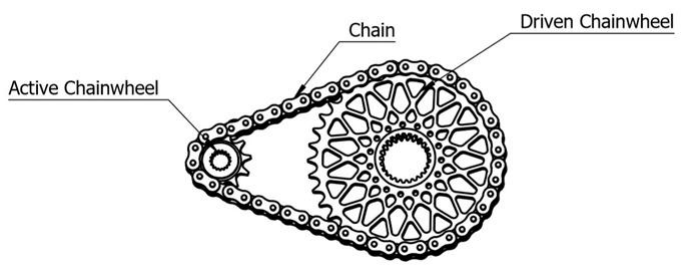
[picture p56: figure]

Chainwheel Assembly | System | Engine & Drivetrain
Materials | | Assembly | Chainwheel Assembly
Scale | 1:4
School | Tongji University | Number | A02009
Amount | 1
