Lu-Chengyu/TR19/TR19_Cost_Report/TR19_CR_Part_Drawing/Active Chainwheel.pdf

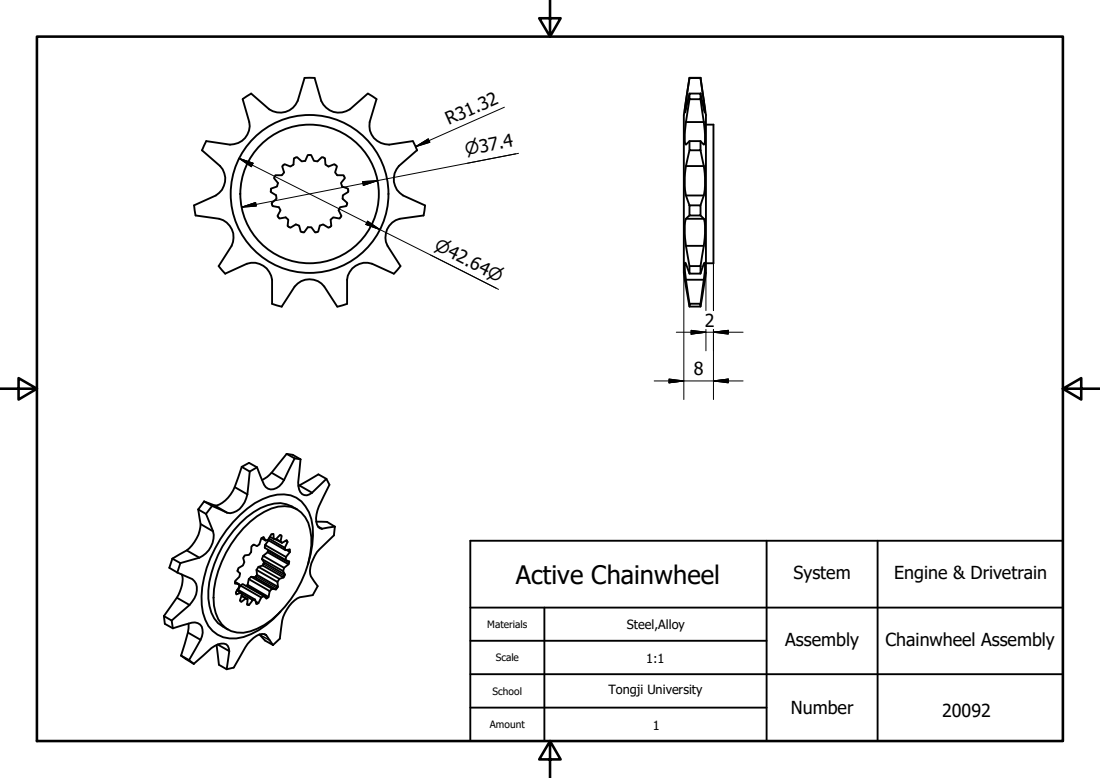
[picture p57: page 1]

Active Chainwheel | System | Engine & Drivetrain

Materials | Steel,Alloy | Assembly | Chainwheel Assembly

Scale | 1:1

School | Tongji University | Number | 20092

Amount | 1
