Lu-Chengyu/TR19/TR19_Cost_Report/TR19_CR_Part_Drawing/Chainwheel Tender.pdf

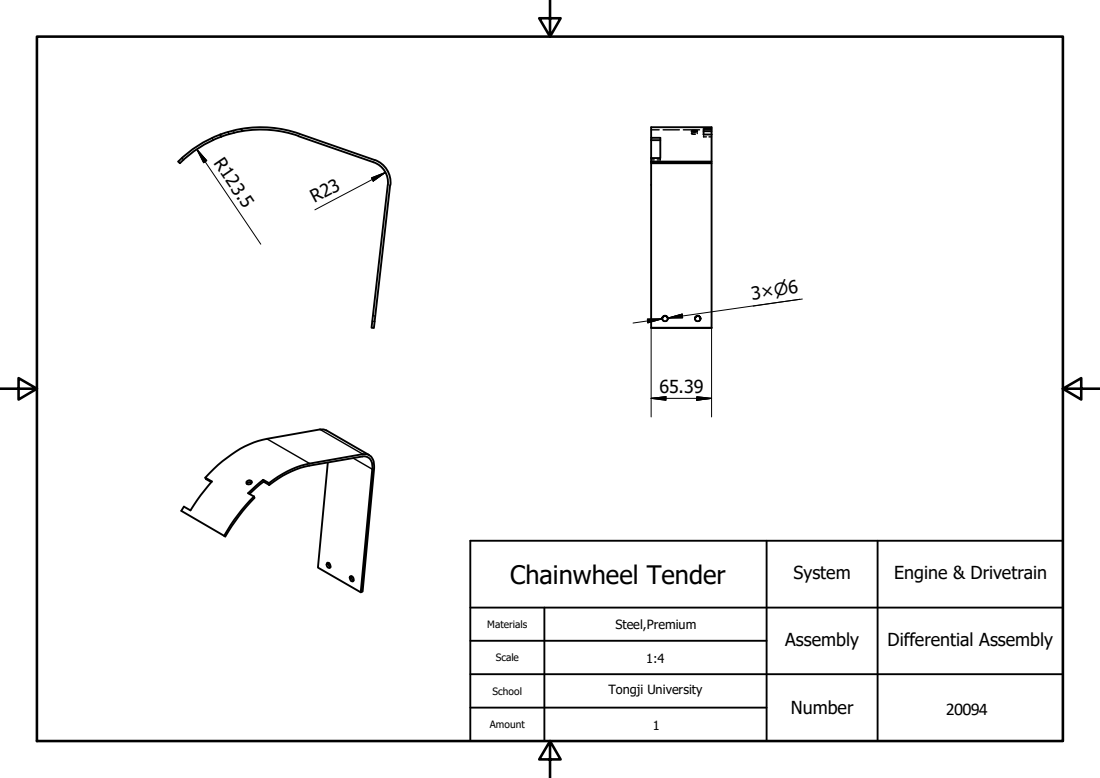
[picture p58: page 1]

Chainwheel Tender | System | Engine & Drivetrain

Materials | Steel,Premium | Assembly | Differential Assembly

Scale | 1:4

School | Tongji University | Number | 20094

Amount | 1
