Lu-Chengyu/TR19/TR19_Cost_Report/TR19_CR_Part_Drawing/Chainwheel Washer.pdf

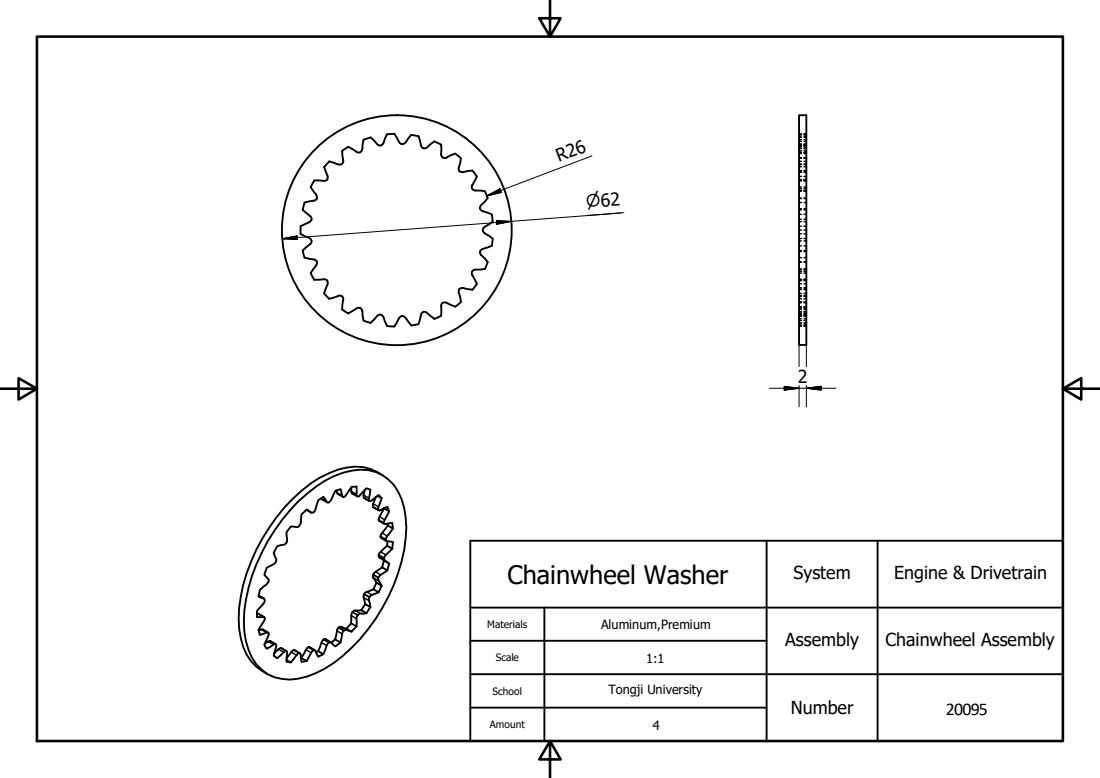
[picture p59: page 1]

Chainwheel Washer | System | Engine & Drivetrain

Materials | Aluminum,Premium | Assembly | Chainwheel Assembly

Scale | 1:1

School | Tongji University | Number | 20095

Amount | 4
