Lu-Chengyu/TR19/TR19_Cost_Report/TR19_CR_Part_Drawing/Chainwheel.pdf

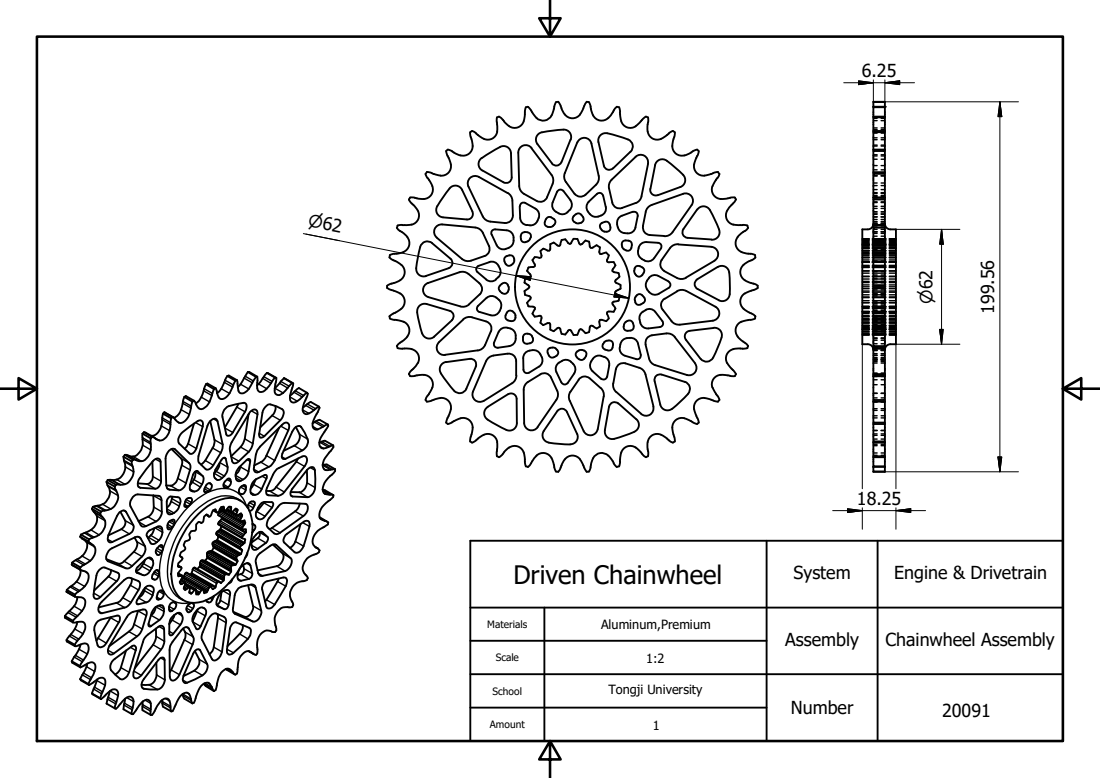
[picture p60: page 1]

Driven Chainwheel | System | Engine & Drivetrain

Materials | Aluminum,Premium | Assembly | Chainwheel Assembly

Scale | 1:2

School | Tongji University | Number | 20091

Amount | 1
