Lu-Chengyu/TR19/TR19_Cost_Report/TR19_CR_Part_Drawing/Half Alex_L.pdf

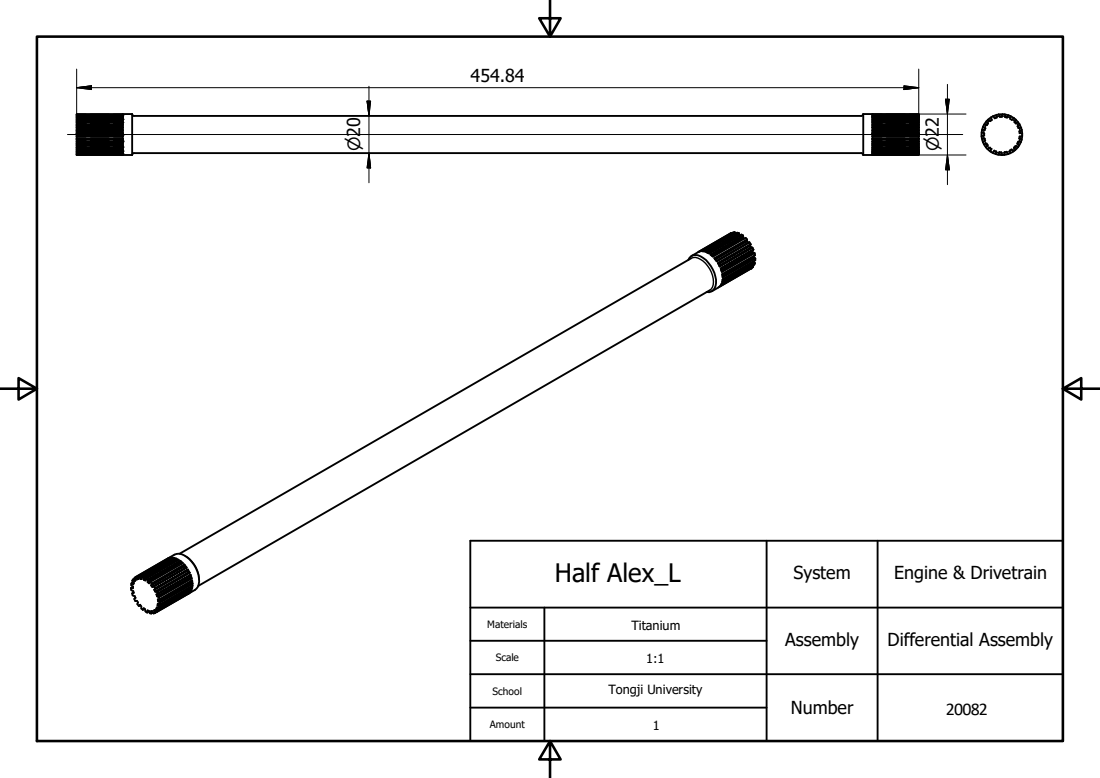
[picture p61: page 1]

Half Alex_L | System | Engine & Drivetrain

Materials | Titanium | Assembly | Differential Assembly

Scale | 1:1

School | Tongji University | Number | 20082

Amount | 1
