Lu-Chengyu/TR19/TR19_Cost_Report/TR19_CR_Part_Drawing/Half Alex_R.pdf

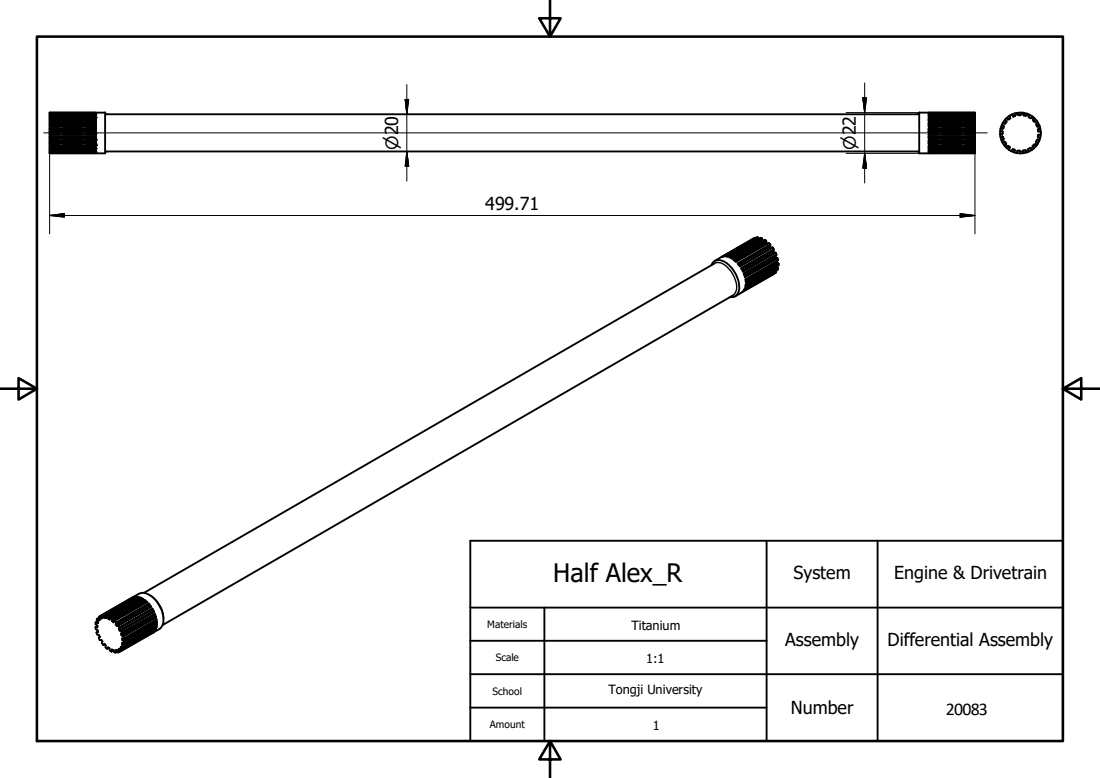
[picture p62: page 1]

Half Alex_R | System | Engine & Drivetrain

Materials | Titanium | Assembly | Differential Assembly

Scale | 1:1

School | Tongji University | Number | 20083

Amount | 1
