Lu-Chengyu/TR19/TR19_Cost_Report/TR19_CR_Part_Drawing/Tensioning_D.pdf

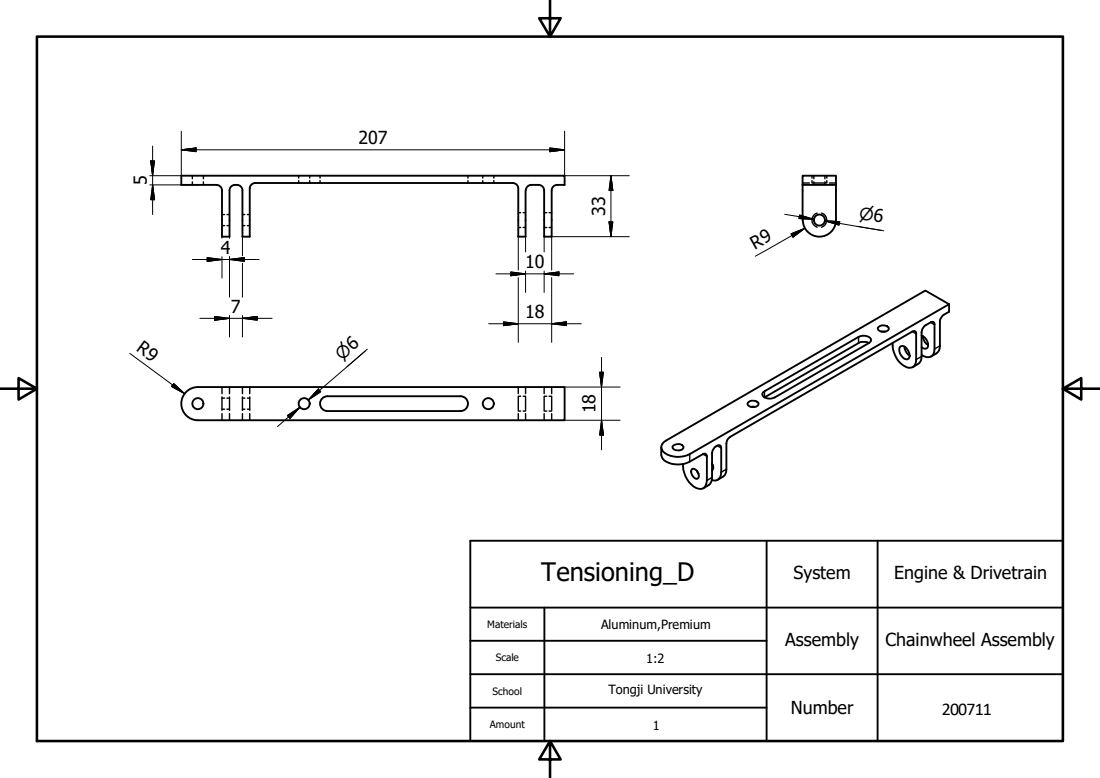
[picture p63: page 1]

Tensioning_D | System | Engine & Drivetrain

Materials | Aluminum,Premium | Assembly | Chainwheel Assembly

Scale | 1:2

School | Tongji University | Number | 200711

Amount | 1
