Lu-Chengyu/TR19/TR19_Cost_Report/TR19_CR_Part_Drawing/Tensioning_U.pdf

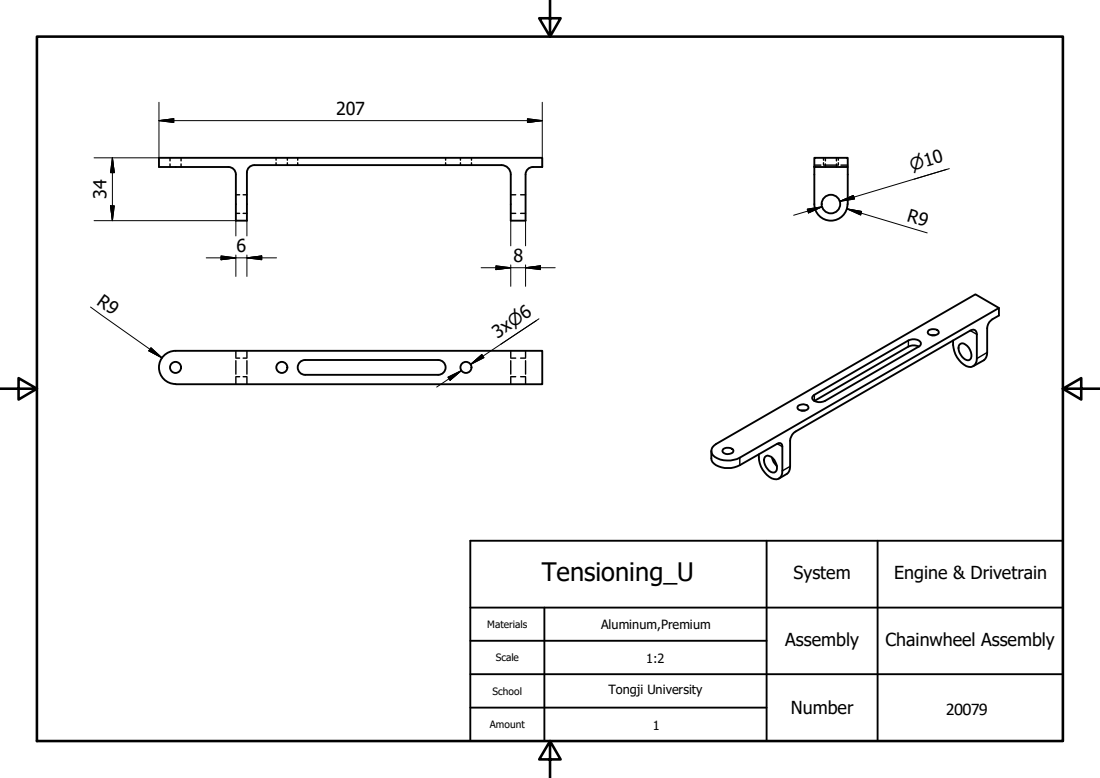
[picture p64: page 1]

Tensioning_U | System | Engine & Drivetrain

Materials | Aluminum,Premium | Assembly | Chainwheel Assembly

Scale | 1:2

School | Tongji University | Number | 20079

Amount | 1
