Lu-Chengyu/TR19/TR19_Cost_Report/TR19_CR_Part_Drawing/Tensioning_W.pdf

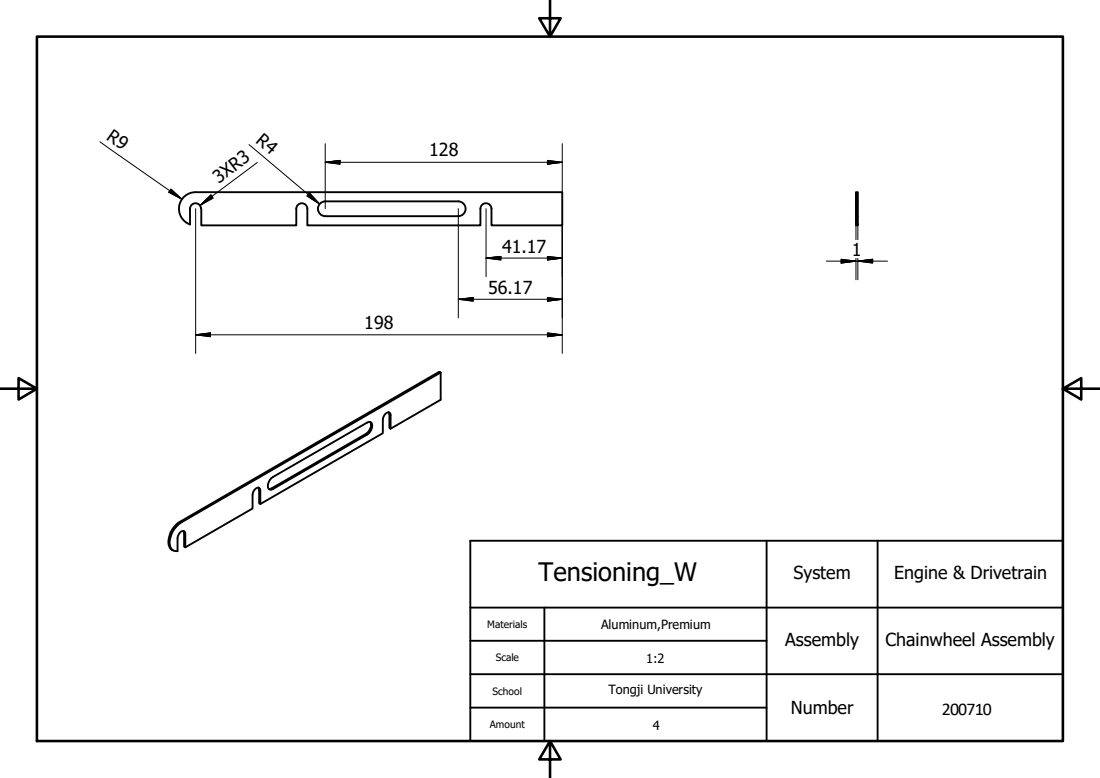
[picture p65: page 1]

Tensioning_W | System | Engine & Drivetrain

Materials | Aluminum,Premium | Assembly | Chainwheel Assembly

Scale | 1:2

School | Tongji University | Number | 200710

Amount | 4
