Lu-Chengyu/TR19/TR19_Cost_Report/TR19_CR_Part_Drawing/Tripod Shaft_R.pdf

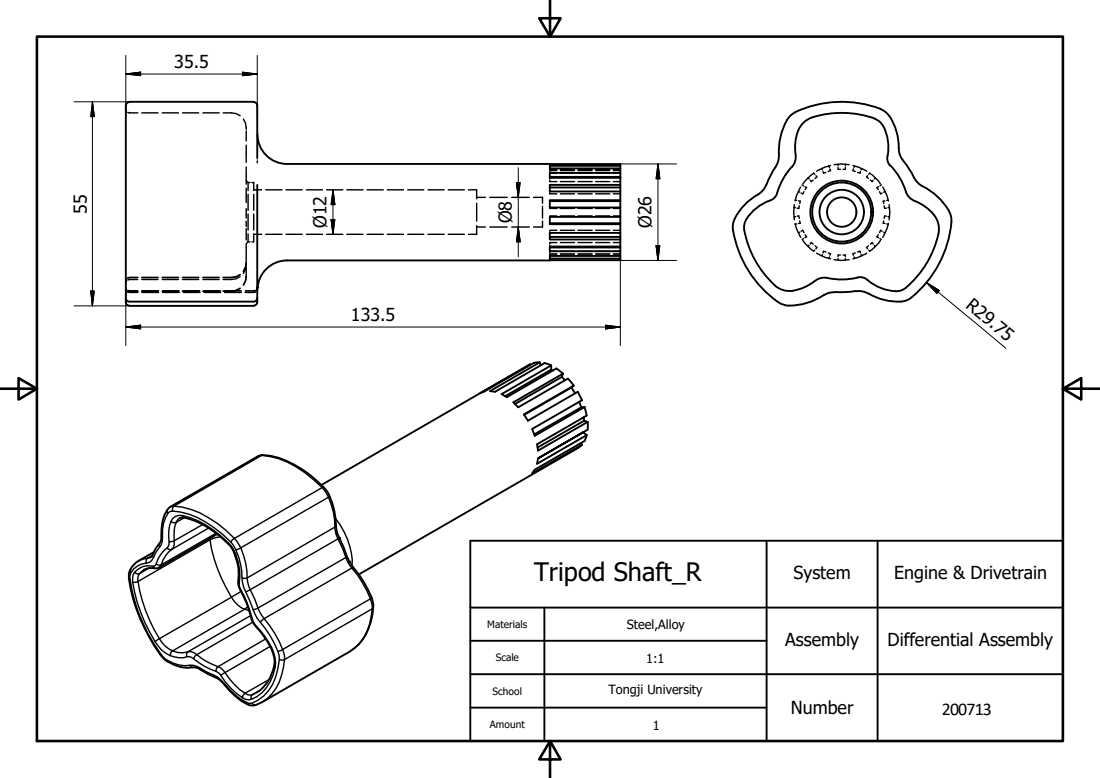
[picture p67: page 1]

Tripod Shaft_R | System | Engine & Drivetrain

Materials | Steel,Alloy | Assembly | Differential Assembly

Scale | 1:1

School | Tongji University | Number | 200713

Amount | 1
